tarosay/Wakayama-mruby-board/Schematic/README.md

DesignSpark PCBのデータです。
パーツライブラリは、下記にて公開しています。
https://bitbucket.org/tarosay/designspark_originallibrary
