tarosay/Wakayama-mruby-board/ruby関西勉強会.pdf

# Wakayama.rb

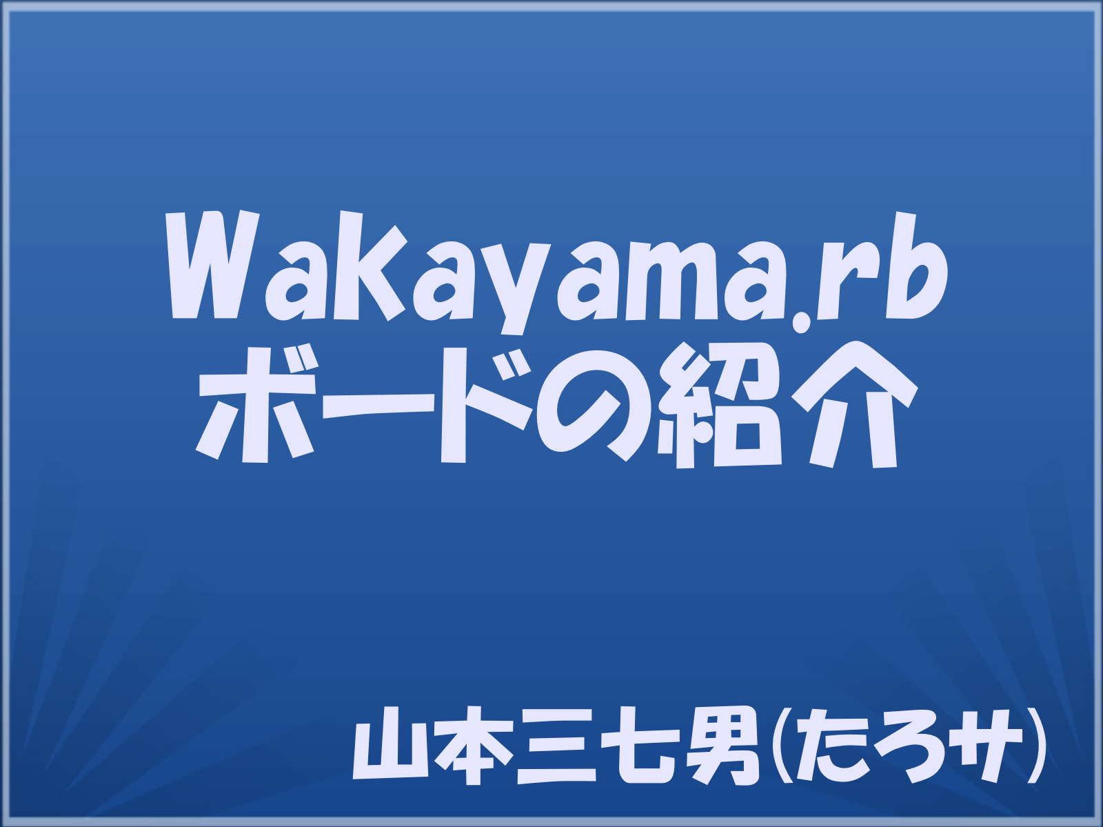
[picture p1: page 1]

# 山本三七男(たろサ)

# ボードの紹介

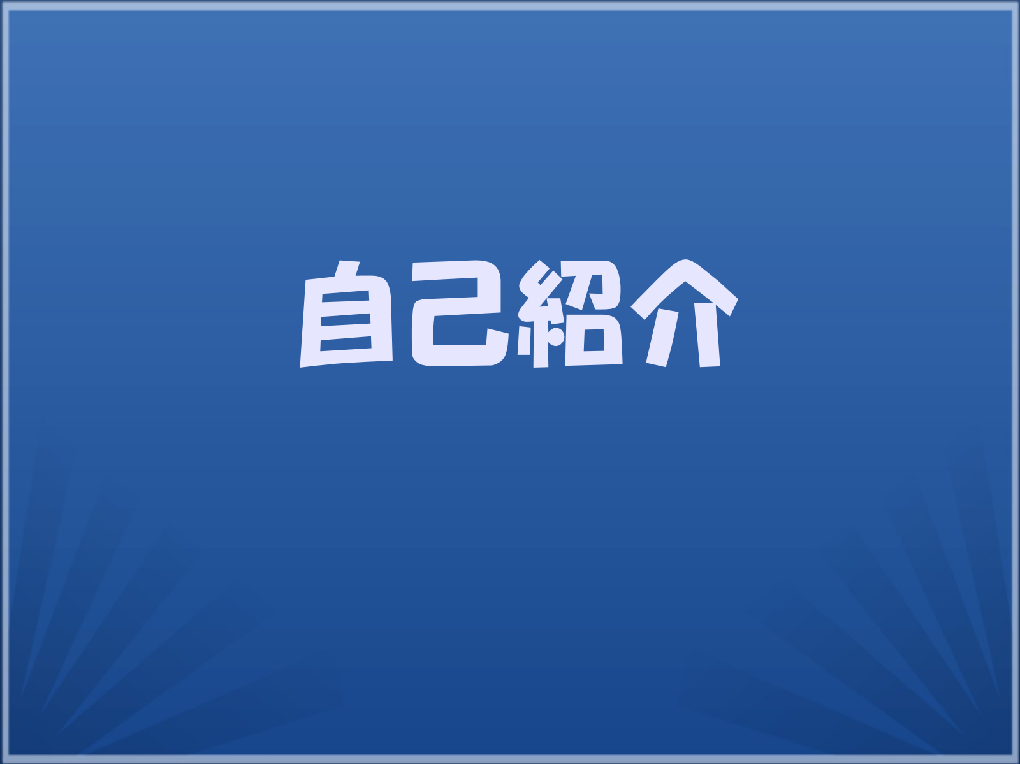
[picture p2: page 2]

# 自己紹介

## 自己紹介

## みかん

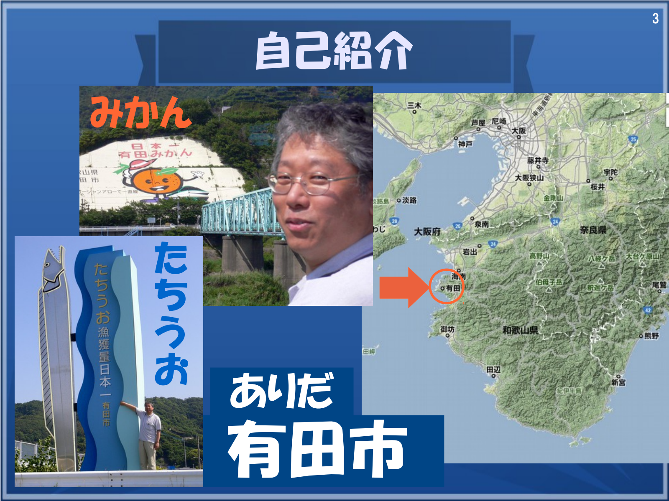
[picture p3: page 3]

3

# 有田市

## ありだ

### たちうお

## 自己紹介

## フリーランスのプログラマを やっています。 さらに、

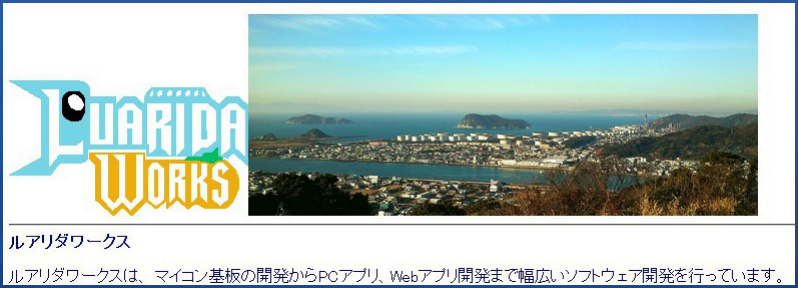
[picture p4: figure]

5

## 自己紹介

## 二足のわらじ

## ビジュアル・テクノロジー研究所

所属

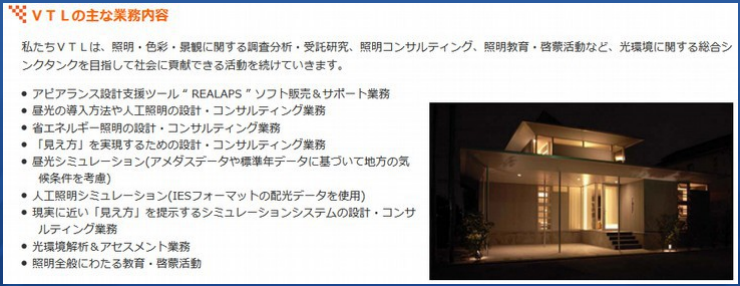
[picture p5: figure]

## ＶＴＬの保有技術

## 自己紹介

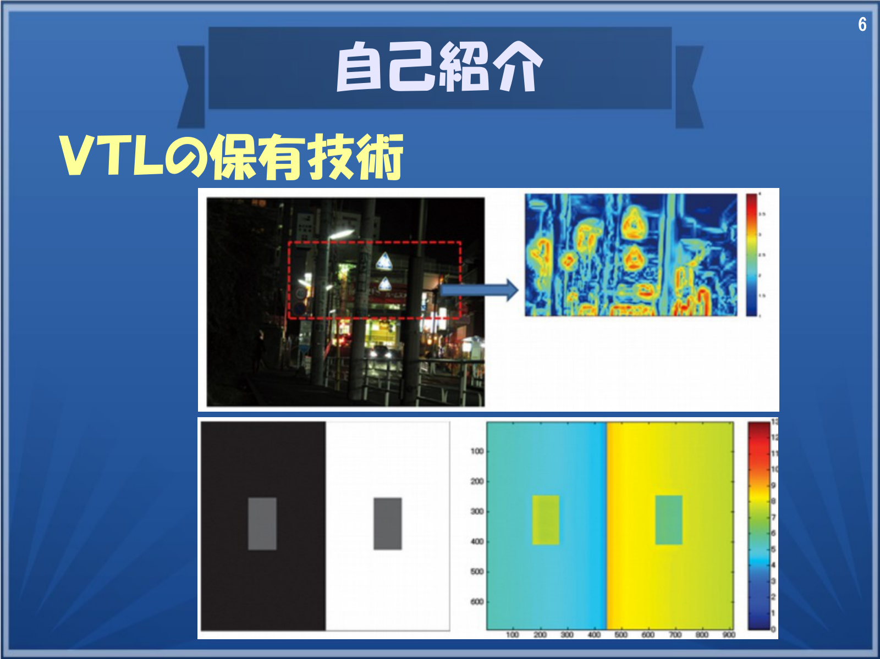
[picture p6: page 6]

6

## 自己紹介

### 毎月、和歌山でRuby勉強会を 行っています。

## Wakayama.rb主催

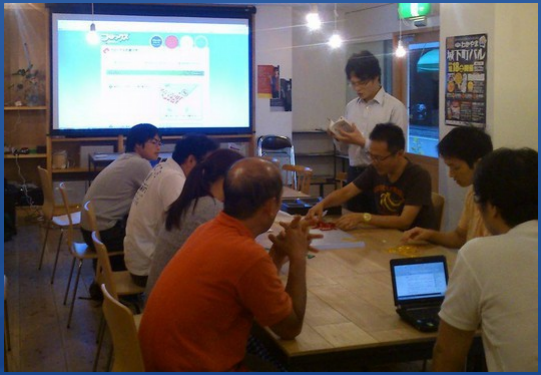
[picture p7: figure]

## 発足の秘密

# Wakayama.rb 発足の理由！！

# 帰りの紀州路快速で 何が話されたか? 発表の最後に！

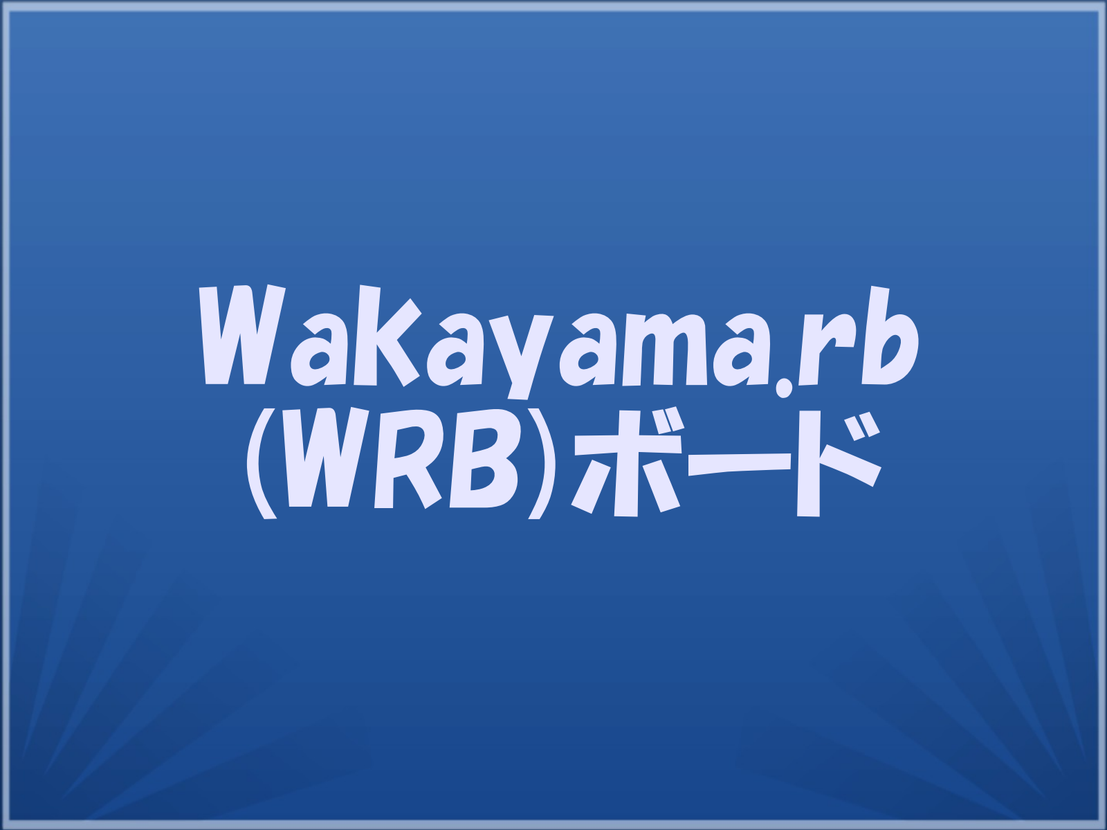
[picture p8: page 9]

# Wakayama.rb (WRB)ボード

10

## WRBボード

## mrubyボード設計・製作

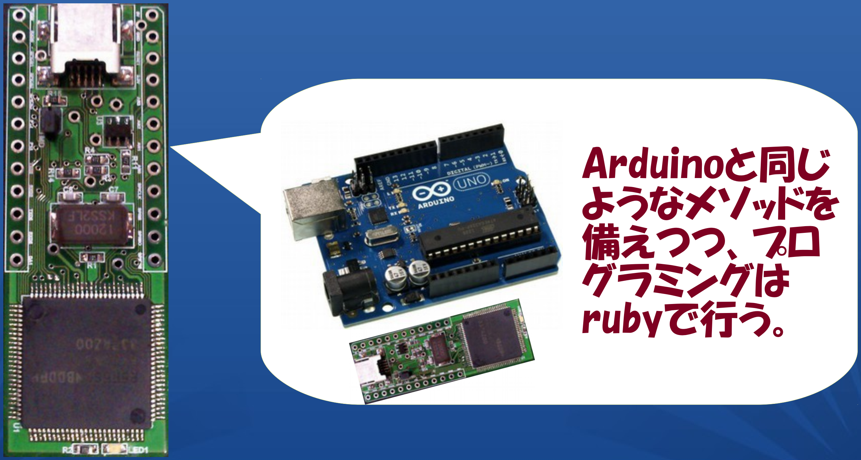
[picture p9: figure]
Arduinoと同じ ようなメソッドを 備えつつ、プロ グラミングは rubyで行う。

# ハードウェア

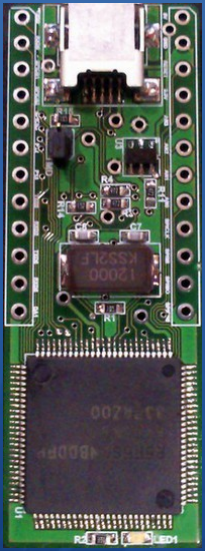
[picture p10: figure]

ボード機能
USBファンクション端子（mini-B）、
LED 1個、
I/Oピン 20ピン、
シリアル 3個、
SPI 1個、
A/D 4個、
I2C、PWM、サーボは自由割当て

## MCU RX63N FlashROM：1Mバイト RAM：128Kバイト データ用Flash：32Kバイト

## ピンアサイン

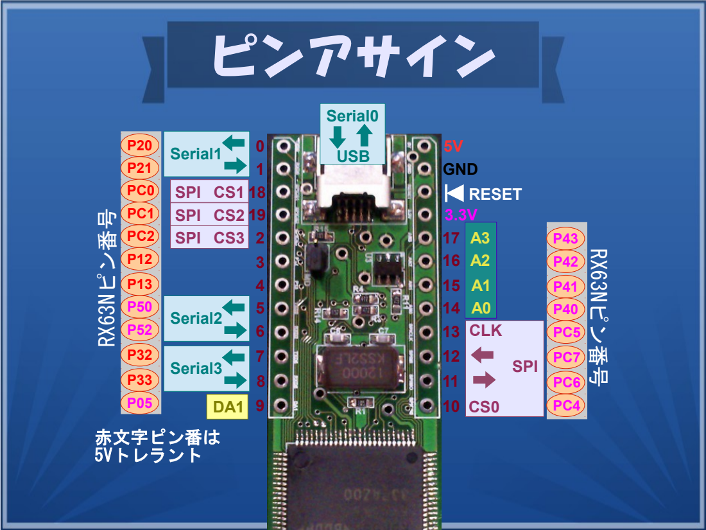
[picture p11: page 12]

## ピンアサイン

## Ver 2.0

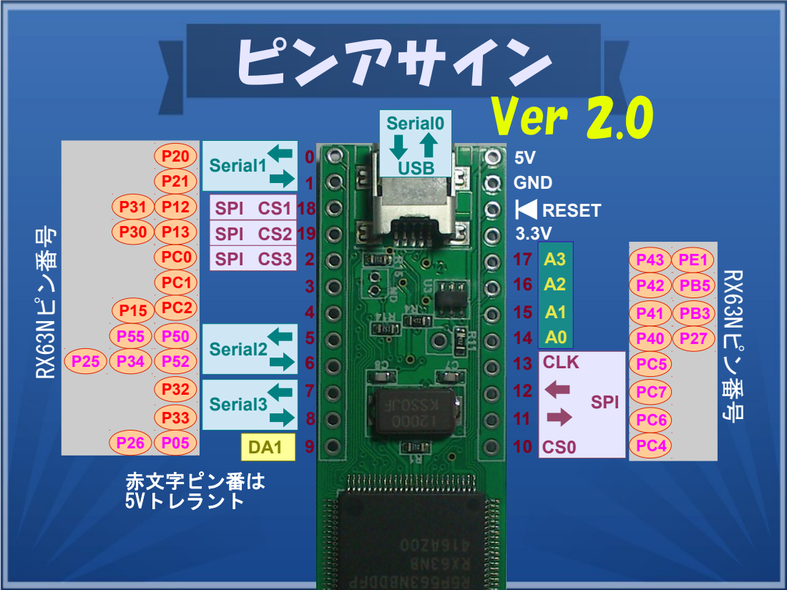
[picture p12: page 13]

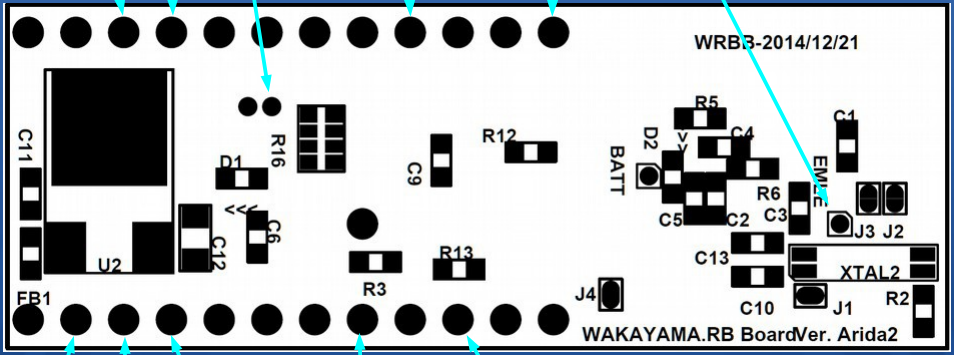
[picture p13: figure]

TCK

MD TRST

SPIMISO

TMS TDI | TDO

GND REST

EMLE

V3.3

## J T A G

## オープンソース化

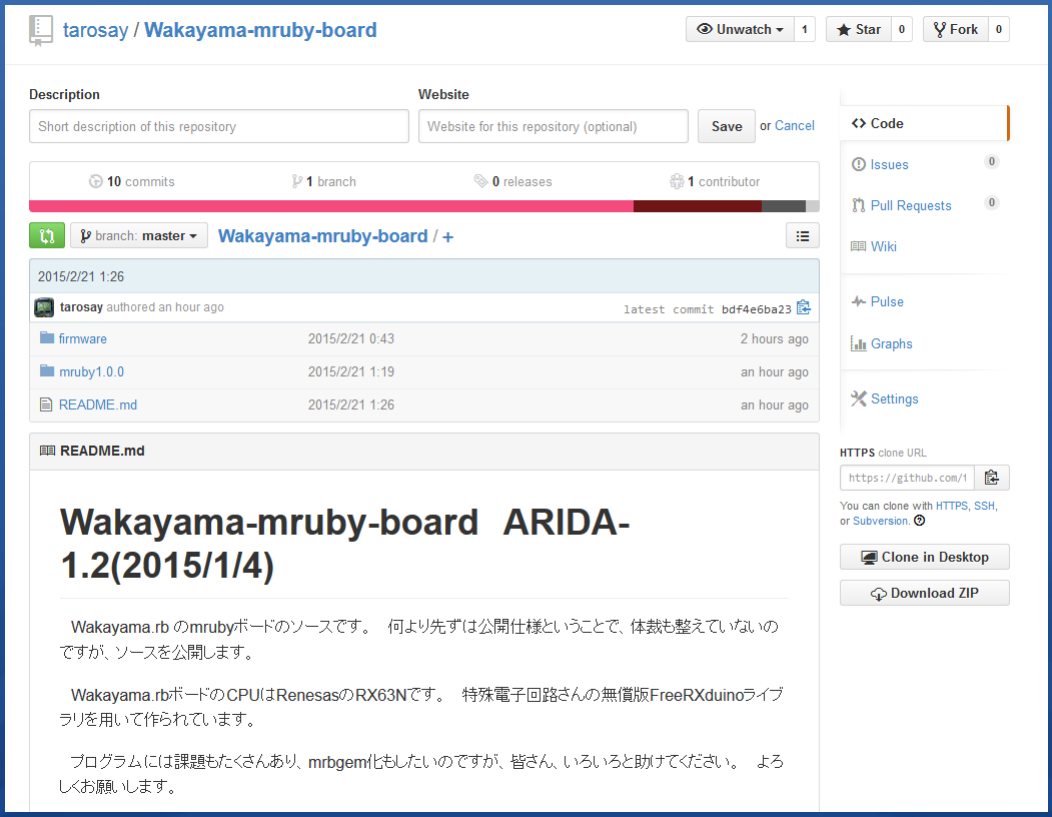
[picture p14: figure]

## ビルド環境

### Windows 編 Cygwinのインストール https://www.cygwin.com/

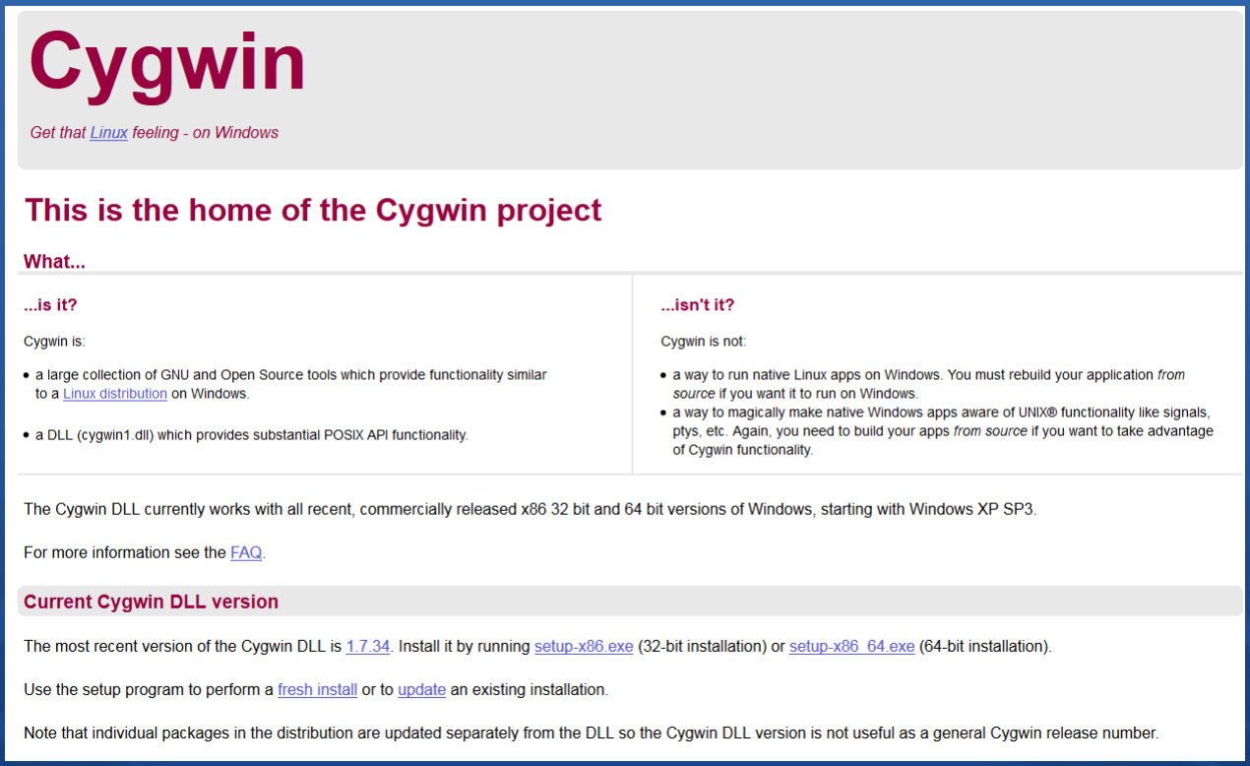
[picture p15: figure]

## ビルド環境

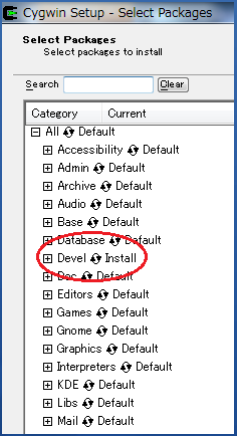
[picture p16: figure]

### Cygwinのインストール

### Develをインストールすれば OKでしょう。

## RX-ELF-GCC環境

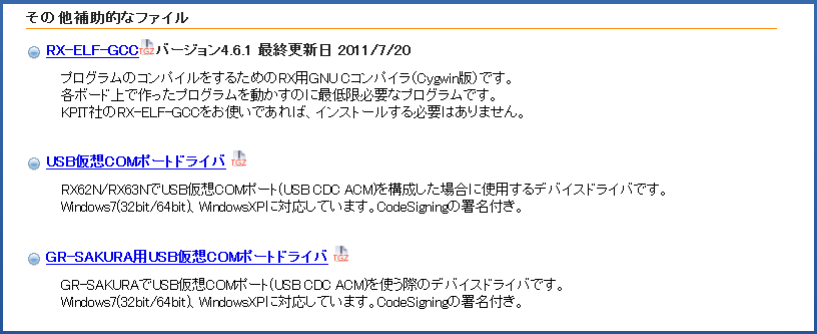
[picture p17: figure]

### 特殊電子回路(株)さんのFreeRXduinoサイト から、RX-ELF-GCCをダウンロード

http://rx.tokudenkairo.co.jp/freesoft.html

## RX-ELF-GCC環境

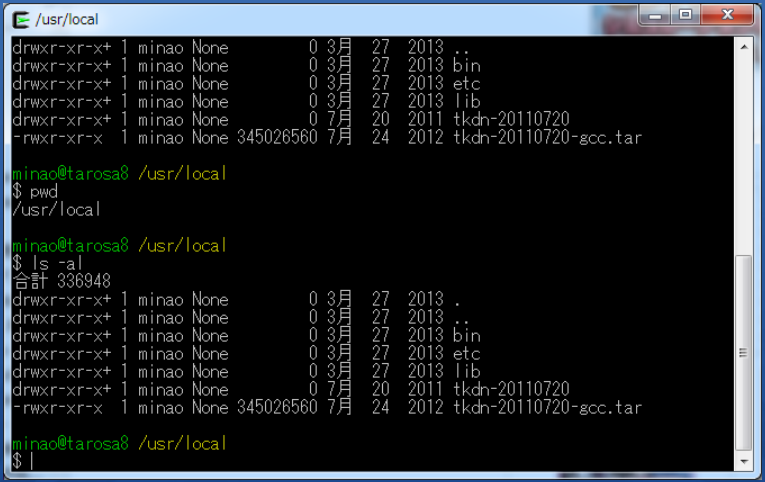
[picture p18: figure]

tar jxvf tkdn-20110720-gcc.tar.bz2

## RX-ELF-GCC環境

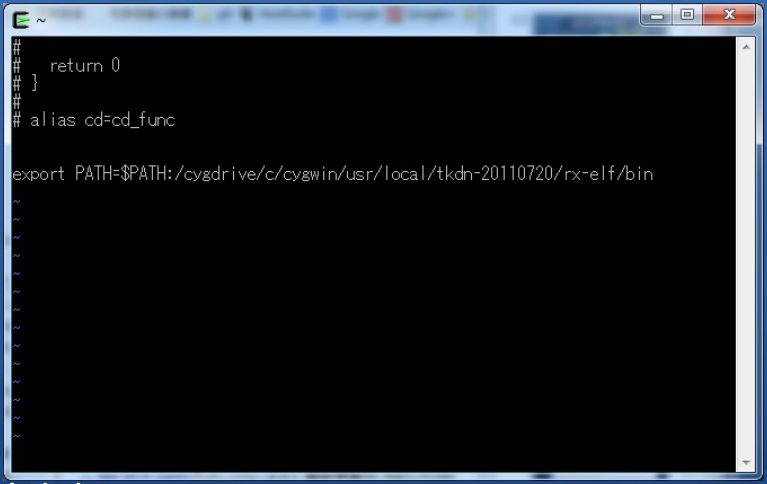
[picture p19: figure]

$ vim .bashrc

export PATH=$PATH:/cygdrive/c/cygwin/usr/local/tkdn-20110720/rx-elf/bin

## RX-ELF-GCC環境

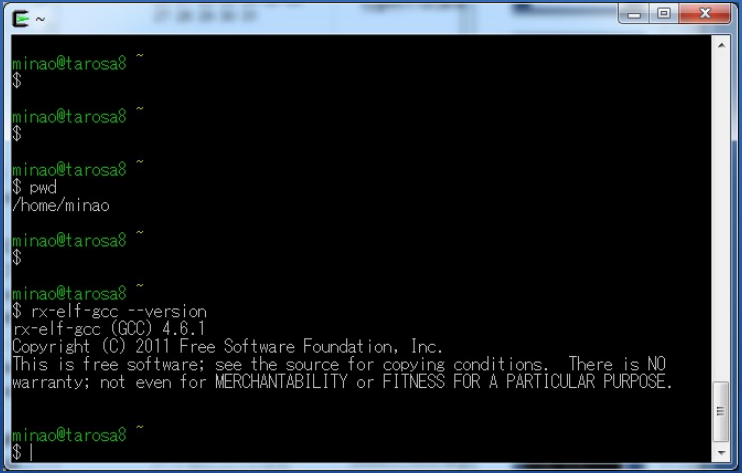
[picture p20: figure]

$ rx-elf-gcc --version

## mrubyのmake

### ただし、mruby1.0.0

## ただし、mruby1.0.0

# ただし、mruby1.0.0

ただし、mruby1.0.0

## mrbconf.h

ただし、mruby1.0.0

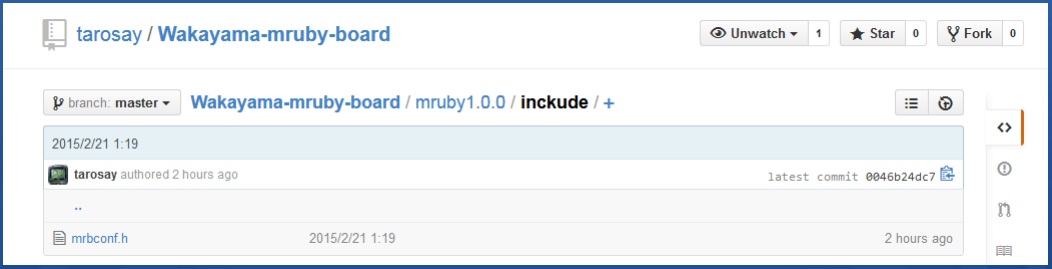
[picture p21: figure]

include/mrbconf.hを入れ替える

git clone https://github.com/tarosay/Wakayama-mruby-board.git

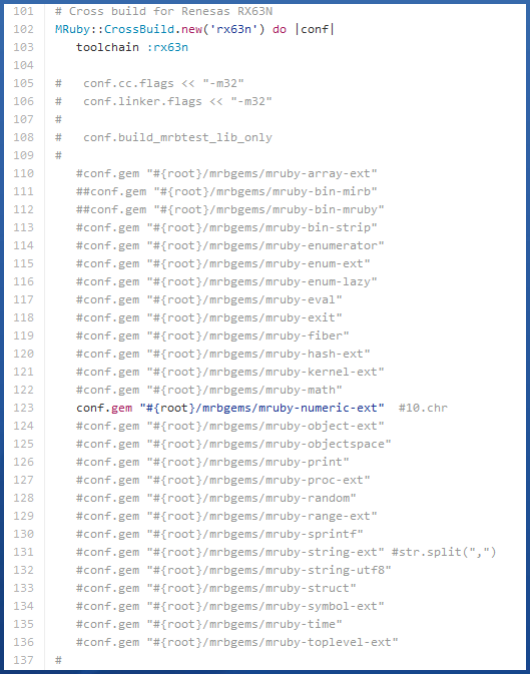
[picture p22: figure]

build_config.rbにRX63N
が追加されている。

## build_config.rb

## rx63n.rake

toolchains/にrx63n.rakeの追加

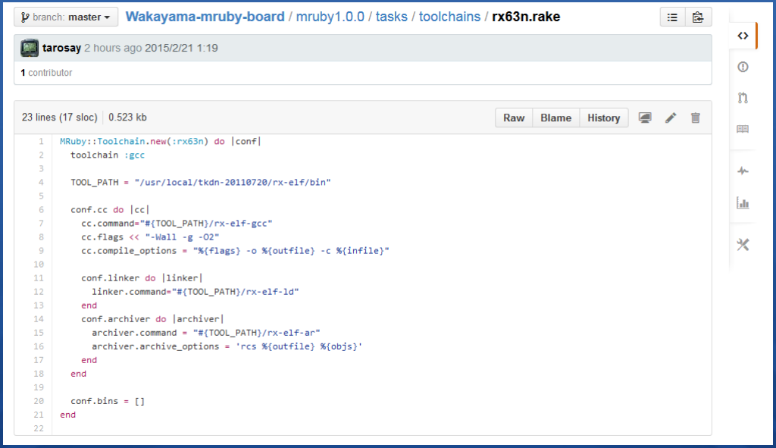
[picture p23: figure]

## mruby make

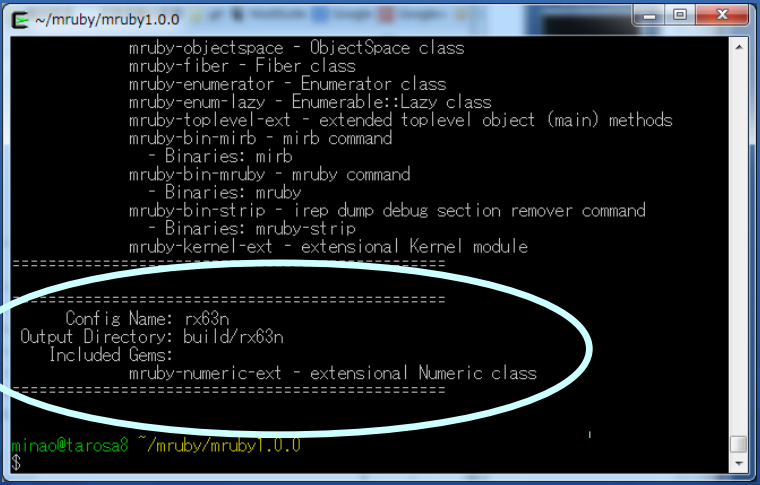
[picture p24: figure]

$ make

## libmruby.a

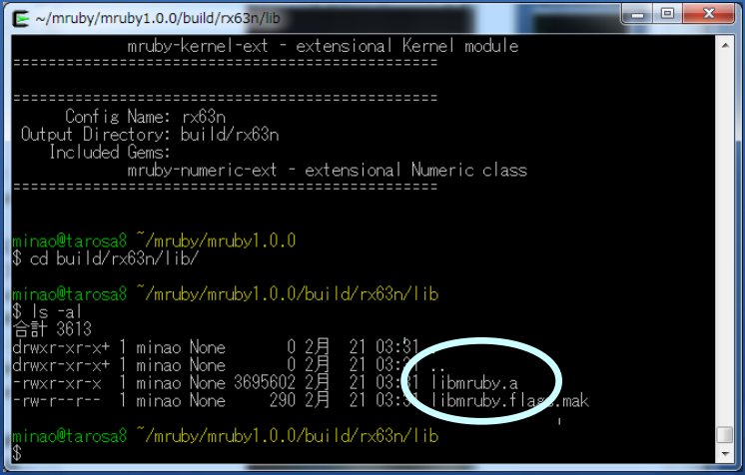
[picture p25: figure]

build/rx63n/lib/libmruby.a

Wakayama-mruby-board

Wakayama-mruby-boardをmakeする

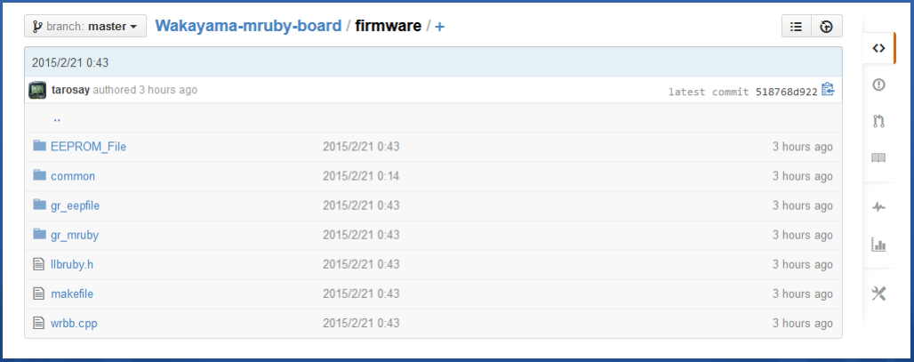
[picture p26: figure]

Wakayama-mruby-board

Wakayama-mruby-boardをmakeする

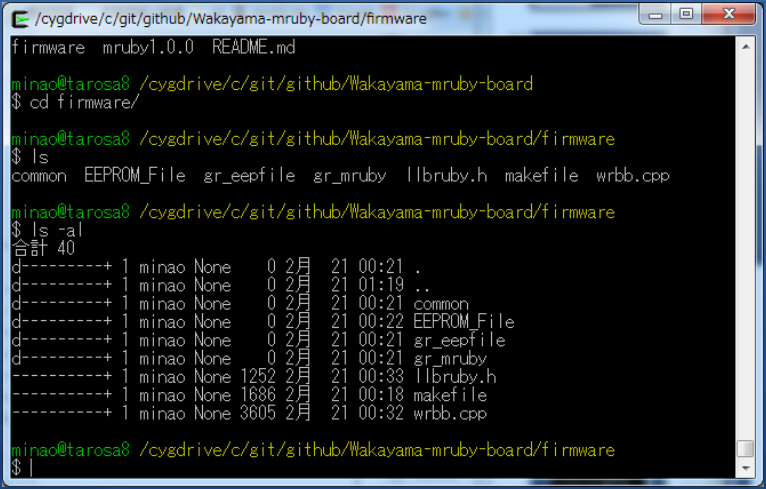
[picture p27: figure]

Wakayama-mruby-board

gr_mruby/以下にlibmruby.aをコピーする

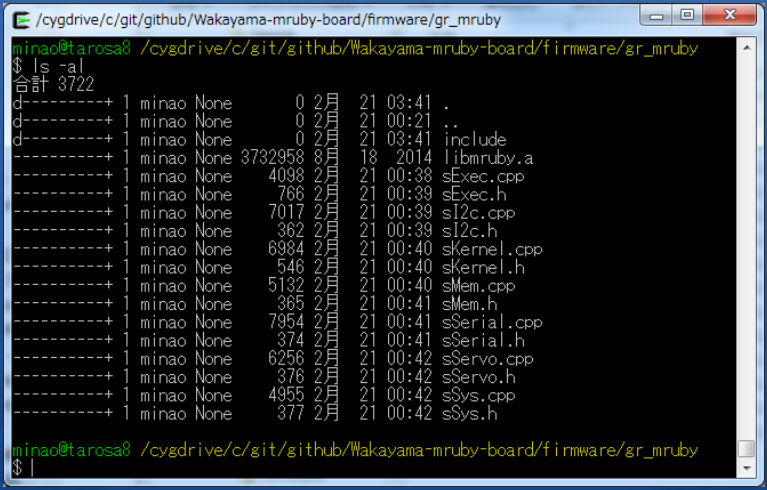
[picture p28: figure]

Wakayama-mruby-board

gr_mruby/include/にmruby.hをコピーする gr_mruby/include/にmruby/をコピーする

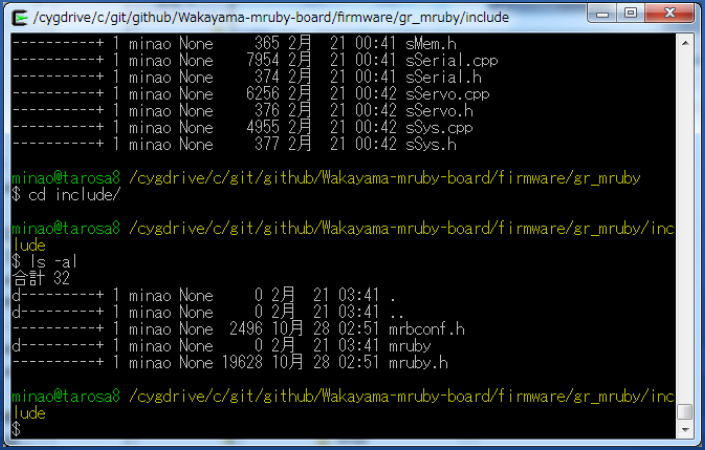
[picture p29: figure]

無償版FreeRXduinoの
ダウンロード

FreeRXduino V1.20 GCC,CubeSuite+,HEW対応版 をダウンロードします

http://rx.tokudenkairo.co.jp/freesoft.html

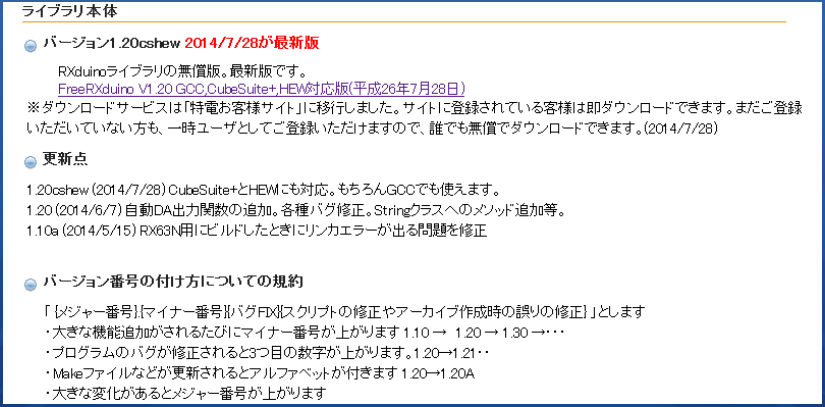
[picture p30: figure]

ライブラリからコピー

FreeRXduinoライブラリ V1.20 から、common/と include/とlib/をコピーします。

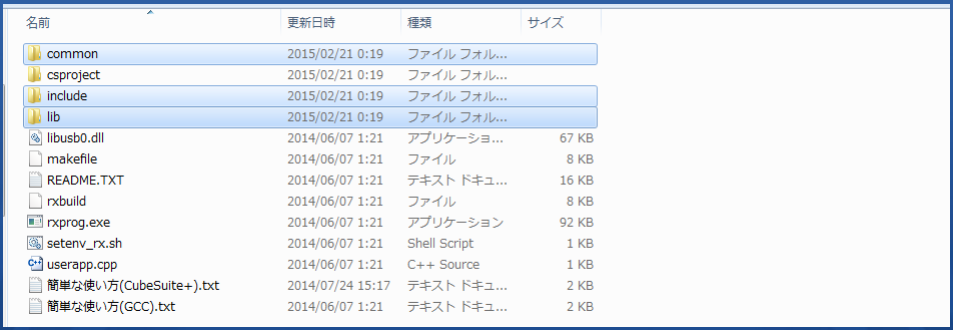
[picture p31: figure]

## make

あとは、makeするだけ

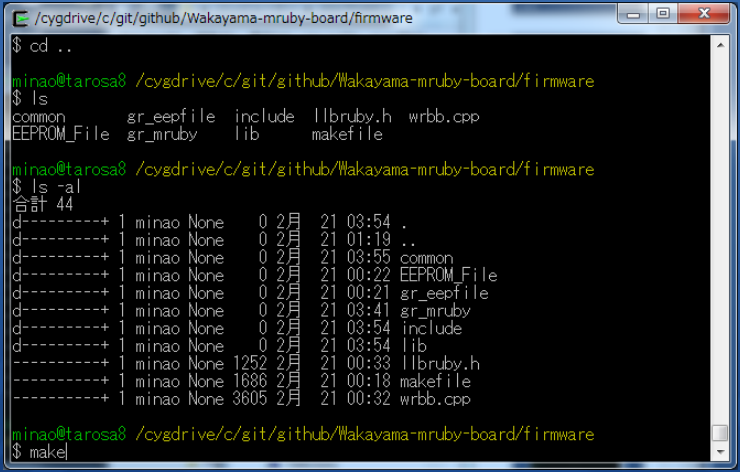
[picture p32: figure]

## wrbb.mot生成

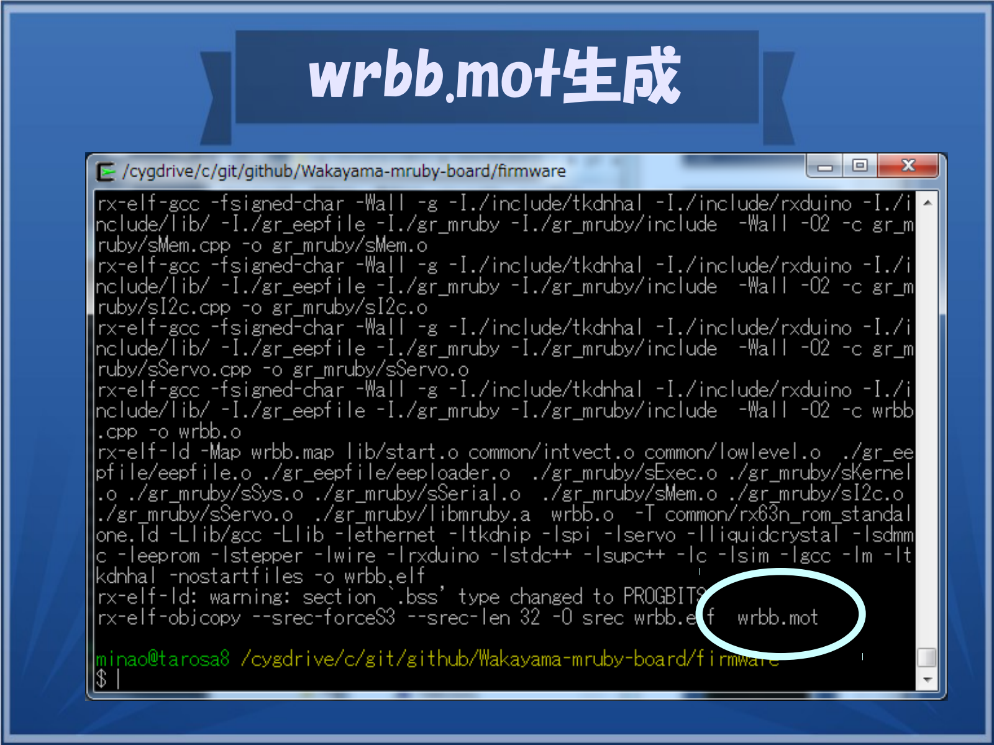
[picture p33: page 35]

## WRBボード書き込み

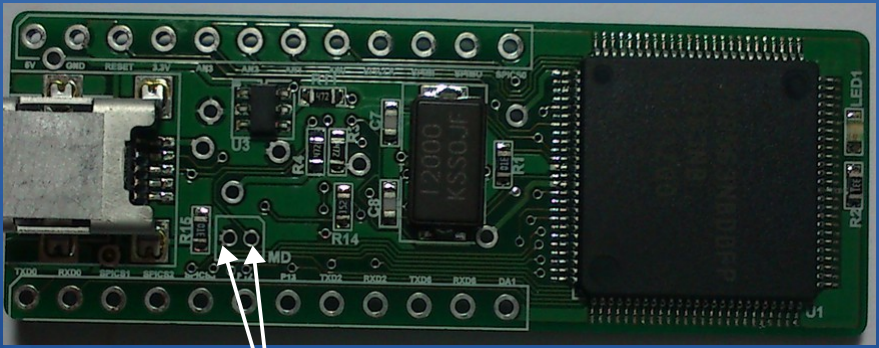
[picture p34: figure]

ここをショートします。

## WRBボード書き込み

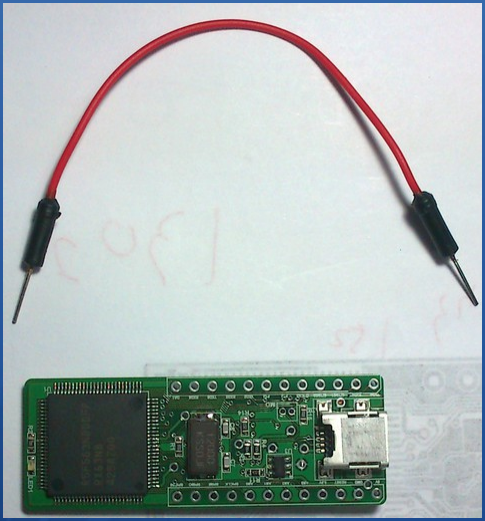
[picture p35: figure]

## みんな持ってる ブレッドボード用配線

## WRBボード書き込み

ここをショートします。

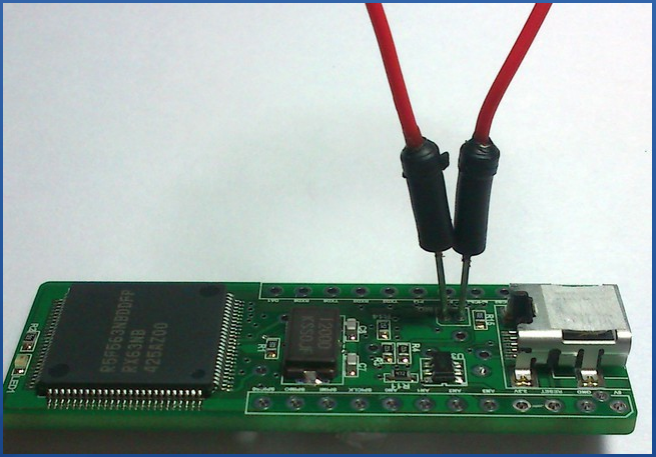
[picture p36: figure]

## WRBボード書き込み

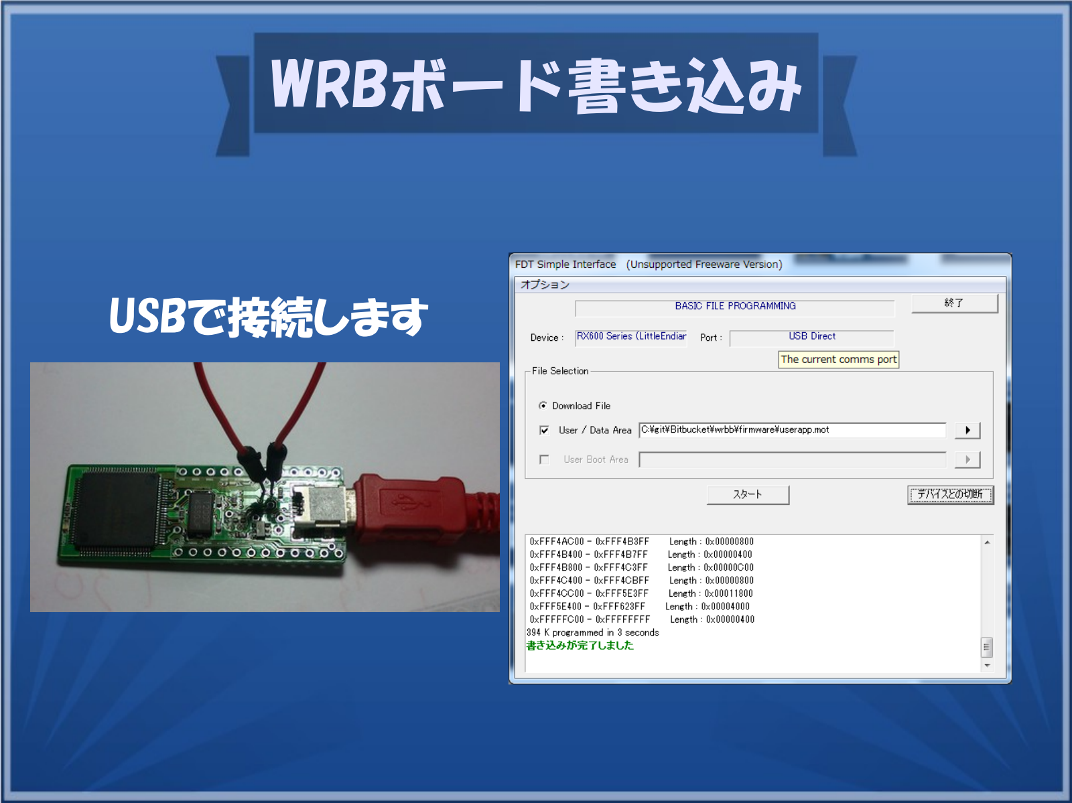
[picture p37: page 39]

USBで接続します

## 時間切れです

### すいません、後は購入してくれた方に・・・。

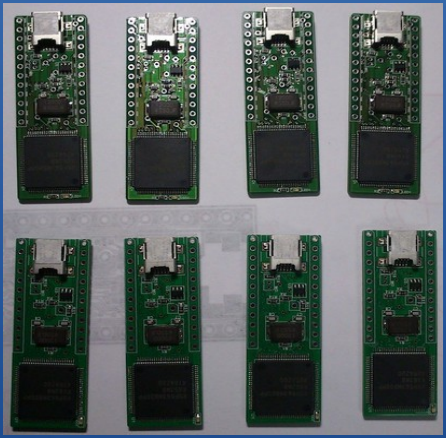
[picture p38: figure]

### 3/22(日) NT京都出展します。

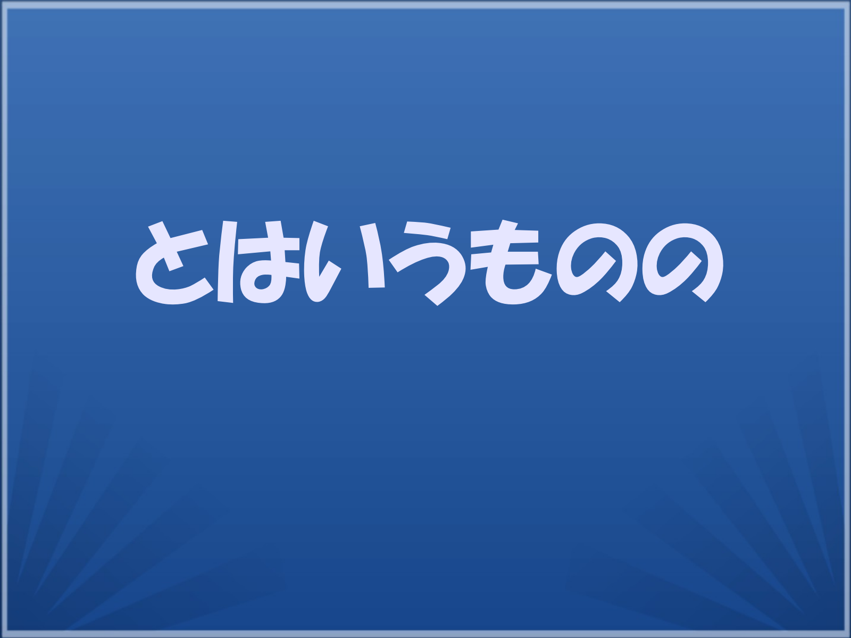
[picture p39: page 41]

# とはいうものの

## 時間切れです

### 売れるものは、4枚しか出来ていません。

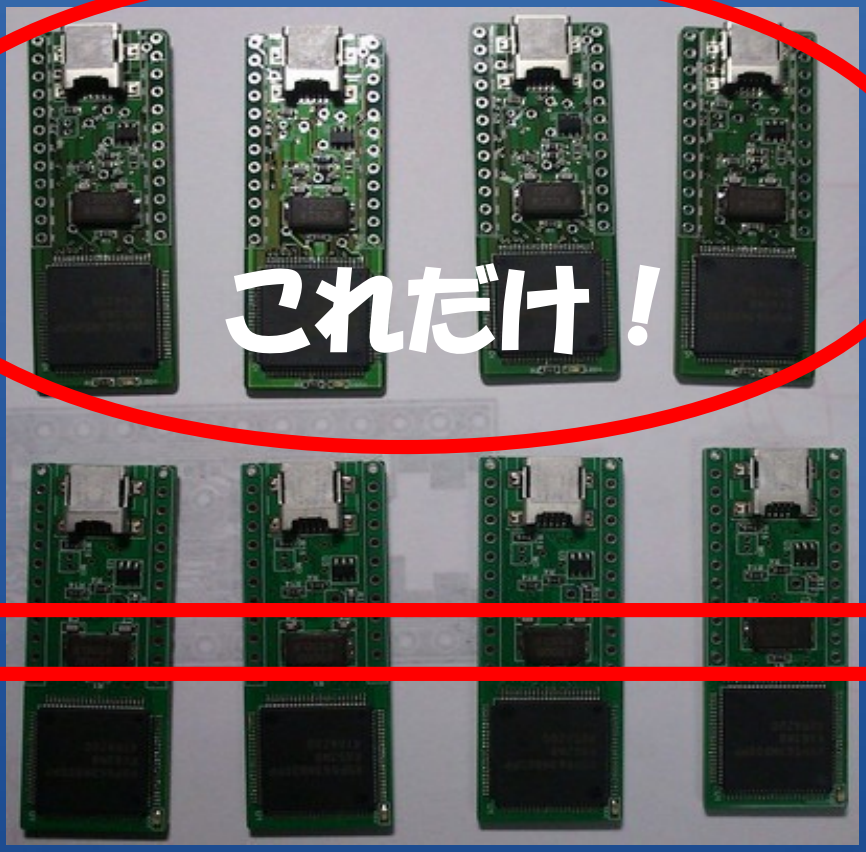
[picture p40: figure]
これだけ！

### 3/22(日) NT京都出展します。

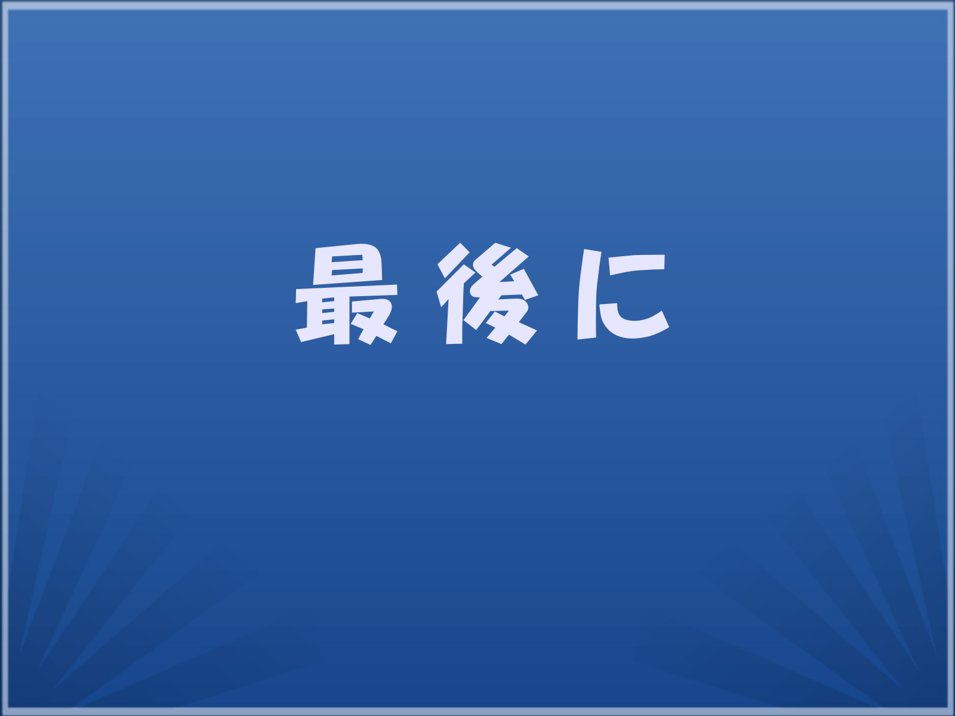
[picture p41: page 43]

# 最 後 に

## mrubyでIoTが変る

### mrubyボード

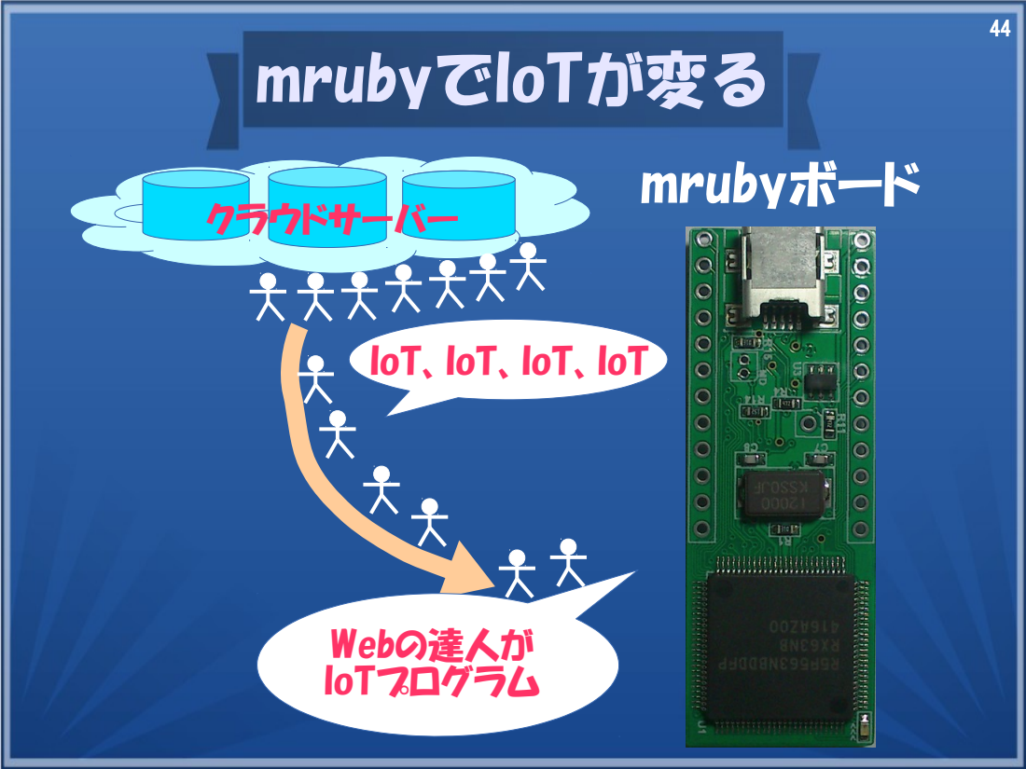
[picture p42: page 44]
小 桜 クラウドサーバー; Webの達人が IoTプログラム

IoT、IoT、IoT、IoT

## mrubyでIoTが変る

## サーバ～組み込み

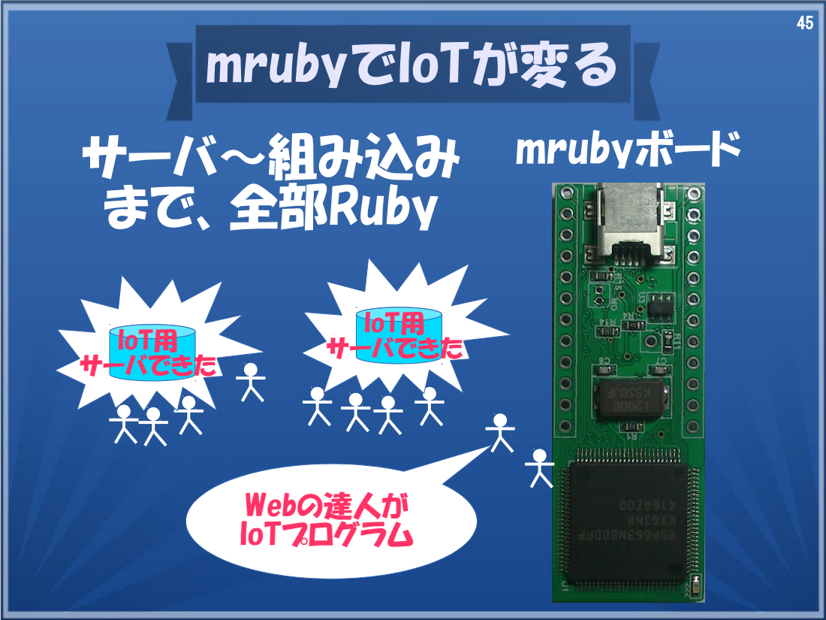
[picture p43: page 45]
Webの達人が IoTプログラム; IoT用 IoT用; サーバできた サーバできた; まで、全部Ruby; mrubyボード

# Wakayama.rb

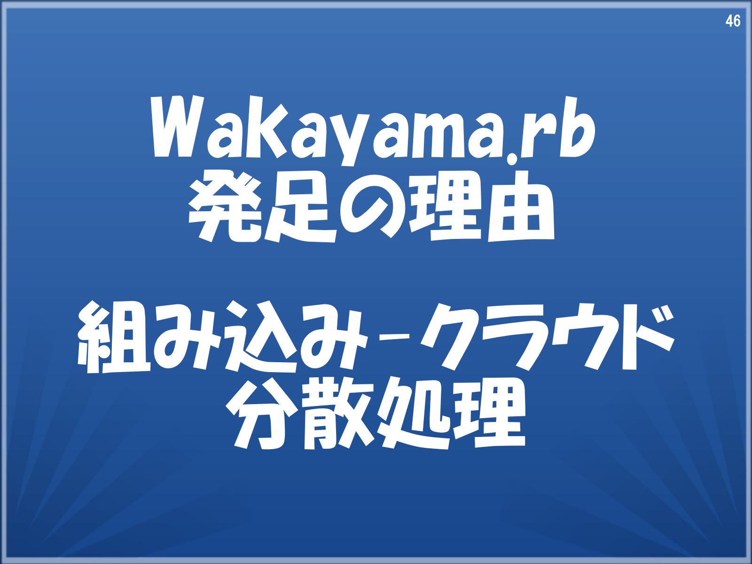
[picture p44: page 46]

46

# 組み込み-クラウド 分散処理

46

# 発足の理由

### クラウド分散

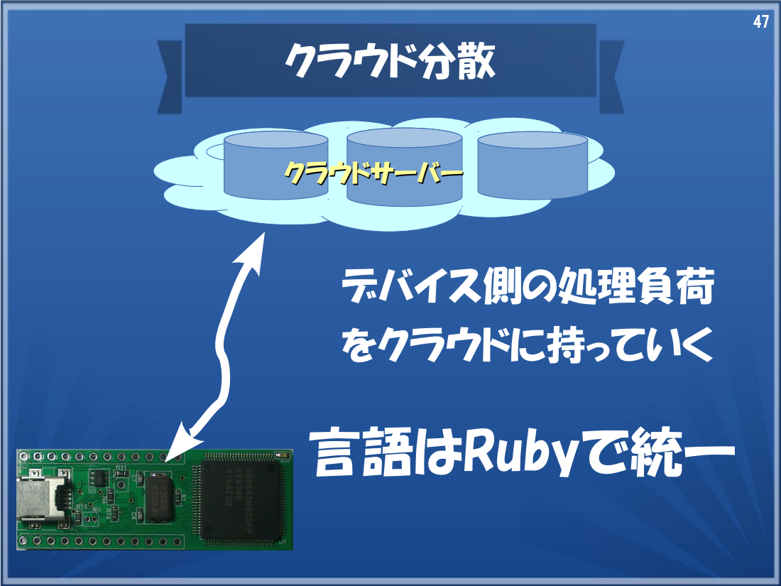
[picture p45: page 47]
デバイス側の処理負荷; をクラウドに持っていく; クラウドサーバー; 言語はRubyで統一

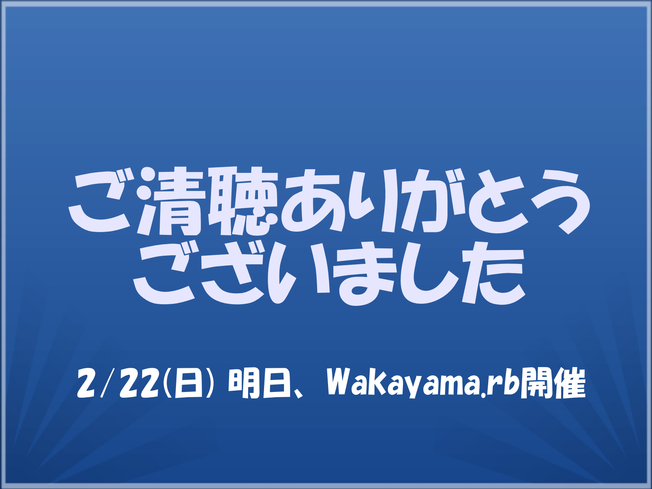
[picture p46: page 48]

# ご清聴ありがとう ございました

### 2/22(日) 明日、 Wakayama.rb開催
