tarosay/Wakayama-mruby-board/BoardDescription/WRB board hands-on text.pdf

# Rubyボードハンズオン テキスト

## Wakayama.rb 山本三七男(たろサ)

2015/12/12

## 2015/12/13修正版

目次

ハード仕様・・・・・・・・・・・・・・・・・・ 3
ピンマップ・・・・・・・・・・・・・・・・・・ 4
基本ソフト仕様・・・・・・・・・・・・・・・・ 5
ハンズオンで使用するRubyの構文・・・・・・・・ 7 仮想COMポートドライバインストール ・・・・・・ 9 Rubyボードの接続・・・・・・・・・・・・・・・ 11 Rubicの使い方 ・・・・・・・・・・・・・・・・ 13

ハンズオン
1.LEDチカチカ ・・・・・・・・・・・・・・・・ 29 2.Hello World!とLEDチカチカ ・・・・・・・・・ 30 3.スイッチ・・・・・・・・・・・・・・・・・・ 31 4.ブザー・・・・・・・・・・・・・・・・・・・ 33 5.ブザーとスイッチ・・・・・・・・・・・・・・ 35 6.光センサとAD変換・・・・・・・・・・・・・・ 37 7.光センサとAD変換2 ・・・・・・・・・・・・・ 39 8.光センサとブザー・・・・・・・・・・・・・・ 41

プログラムの入手方法・・・・・・・・・・・・・ 43

## ハード仕様

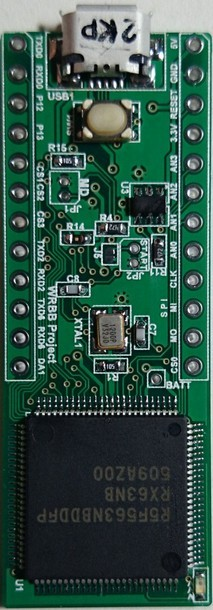
[picture p49: figure]

## MCU 32ビットCPU RX63N(100ピン) 96MHz FlashROM：1Mバイト RAM：128Kバイト データ用Flash：32Kバイト ボード機能 USBファンクション端子（micro-B） LED 1個 I/Oピン 20ピン シリアル 3個(+1個可能) SPI 1個 A/D 4個 RTC I2C、PWM、Servoは自由割当てです。 リセットボタン

電　源

## 5V（USBバスパワード） サイズ

50×18mm

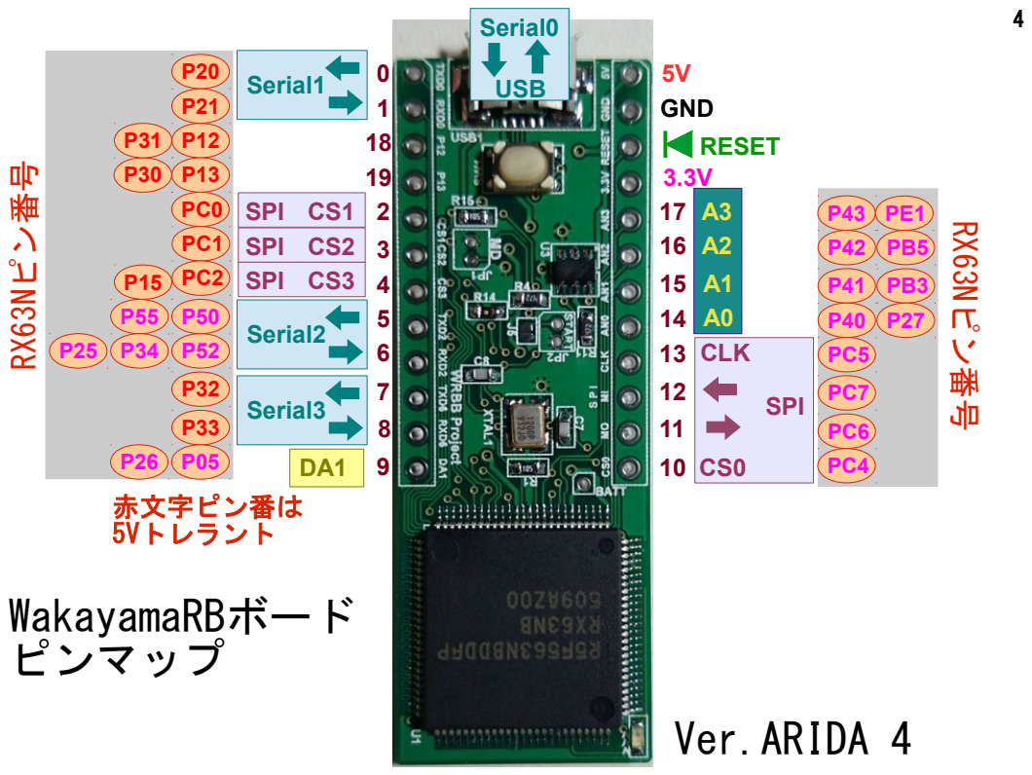
[picture p50: page 4]

カーネルクラス
pinMode(pin,mode)
digitalRead(pin)
digitalWrite(pin,value)
analogRead(number)
pwm(pin,value)
pwmHz(value)
analogDac(value)
delay(value)
millis()
micros()
led(sw)

システムクラス
System.exit()
System.setrun(filename)
System.version(r)
System.push(address,buf,length) System.pop(address,length) System.fileload()
System.reset()

ファイルクラス
MemFile.open(number,filename[,mode]) MemFile.close(number)
MemFile.read(number)
MemFile.write(number,buf,len) MemFile.seek(number,byte)
MemFile.copy(src,dst[,mode])

シリアルクラス
Serial.begin(number,bps)
Serial.setDefault(number)
Serial.print(number,string) Serial.println(number,string) Serial.read(number)
Serial.write(number,buf,len) Serial.available(number)
Serial.end(number)

I2Cクラス
I2c.sdascl(sda,scl)
I2c.write(id,address,data) I2c.read(id,addressL[,addressH]) I2c.begin(id)
I2c.lwrite(data)
I2c.end()
I2c.request(id,count)
I2c.lread()
I2c.freq(Hz)

サーボクラス
Servo.attach(ch,pin[,min,max]) Servo.write(ch,angle)
Servo.us(ch,us)
Servo.read(ch)
Servo.attached(ch)
Servo.detach(ch)

## 基本ソフト仕様

リアルタイムクロッククラス Rtc.begin() Rtc.setDateTime(Year,Month,Day,Hour,Minute,Second) Rtc.getDateTime()

## 基本ソフト仕様

# ハンズオンで使用する Rubyの構文

# 【繰り返しループ】 for i in 1..10 do Serial.print(0, i.to_s) #-> 1～10 end 10.times do|i| Serial.print(0, i.to_s) #-> 0～10 end while 条件文 [do]

処理

# end

## Rubyの構文 いろいろな書き方ができます

# 【条件演算子】C言語と同じです a == b bがaに等しい a != b bがaに等しくない a > b bよりaが大きい a >= b bよりaが大きいか等しい a < b bよりaが小さい a <= b bよりaが小さいか等しい

# 【条件分岐】 if 条件文 then

処理

# elsif 条件文 then

処理

# else

処理

# end 【if修飾子】 Serial.print(0, “Hello”) if a > 10 #->真のとき 【unless修飾子】 Serial.print(0, “Hello”) unless a > 10 #->偽のとき

# USB仮想COMポートドライバ インストール

## Windowsユーザのみ、 仮想COMポートドライバのインストールが必要です。

# Rubyボードは、特殊電子回路(株)さんの無償版FreeRXduinoライブラリを使用して製作さ れています。 特殊電子回路(株)さんのFreeRXduinoホームページから http://rx.tokudenkairo.co.jp/freesoft.html GR-SAKURA用USB仮想COMポートドライバをダウンロードしてインストールしてください。

# Rubyボードの接続

# 12 Rubyボードの接続

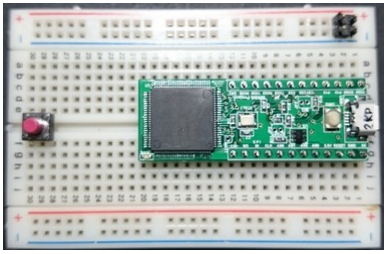
[picture p51: figure]

## ①WRBボードを差し込む

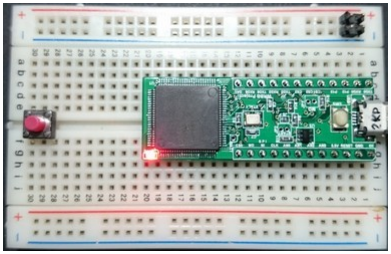
[picture p52: figure]

## ②USBを接続する。

# ここで、Windowsは仮想 COMポートドライバをインス トールします。

# Rubicの使い方

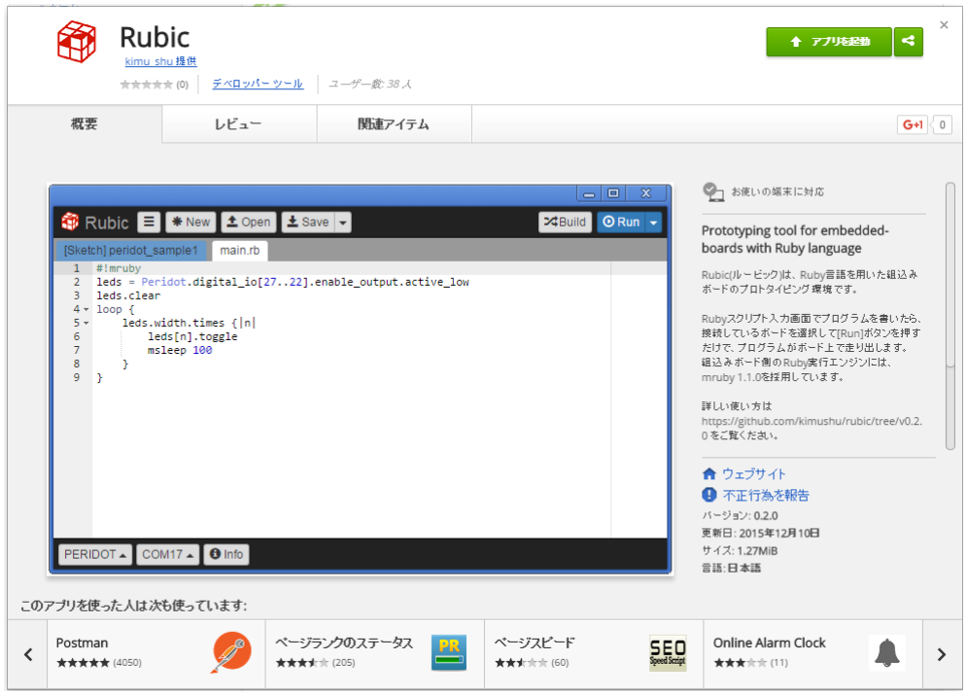
[picture p53: figure]

https://chrome.google.com/webstore/detail/rubic/mgbcgagfggopcpbbfgididddbnhhnhjp

## Rubicのインストール

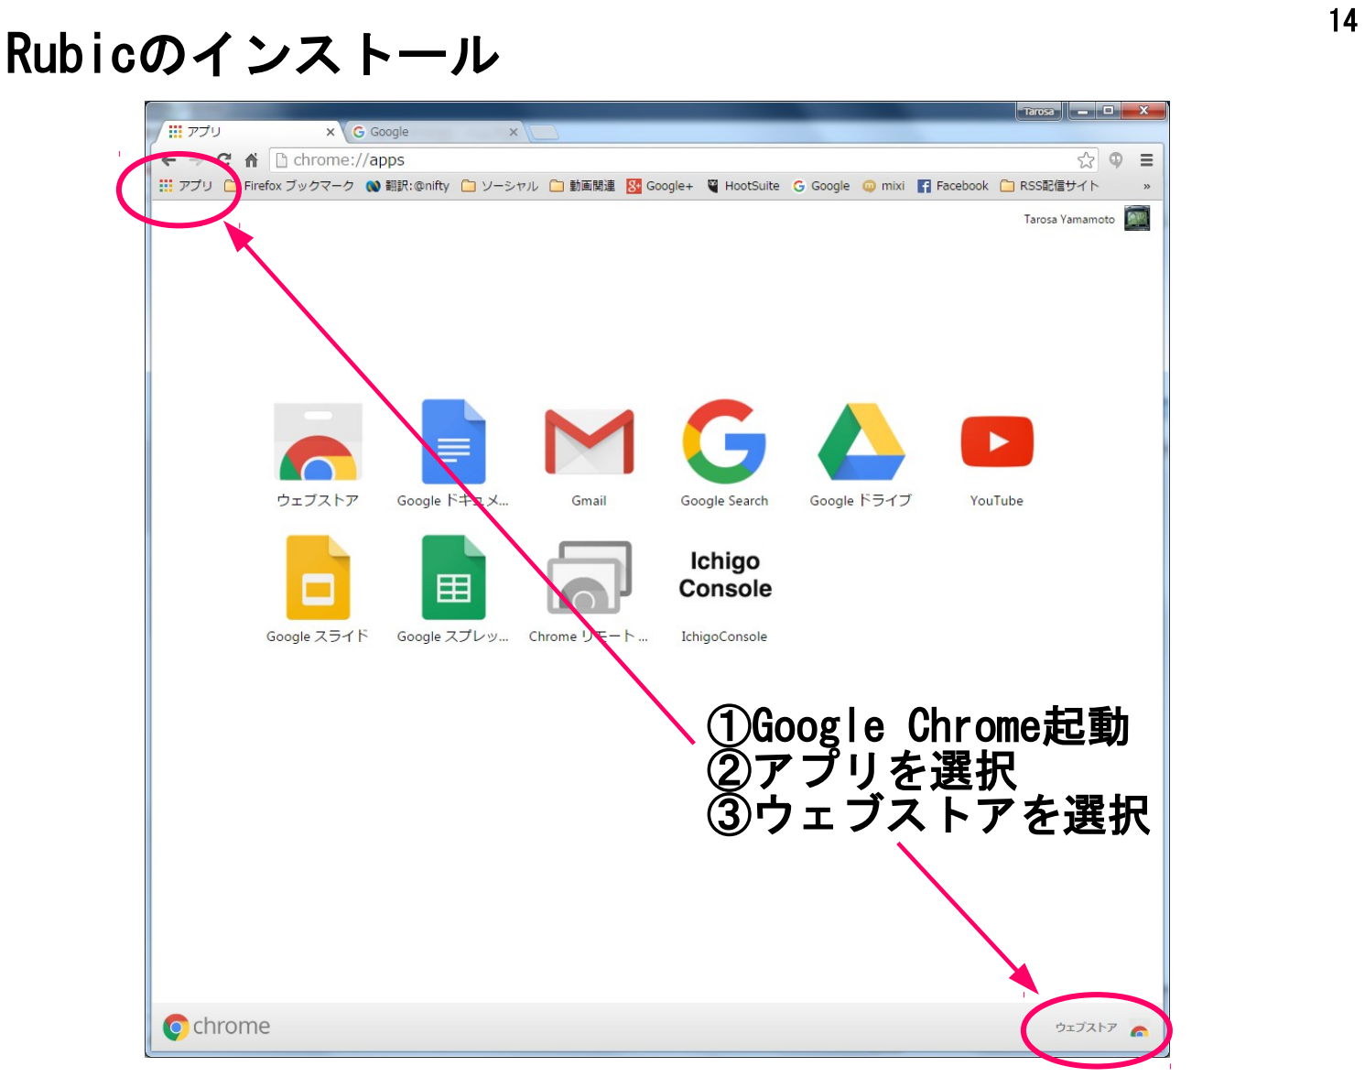
[picture p54: page 14]

## ①Google Chrome起動 ②アプリを選択 ③ウェブストアを選択

## Rubicのインストール

## ①Rubicと入れて検索する

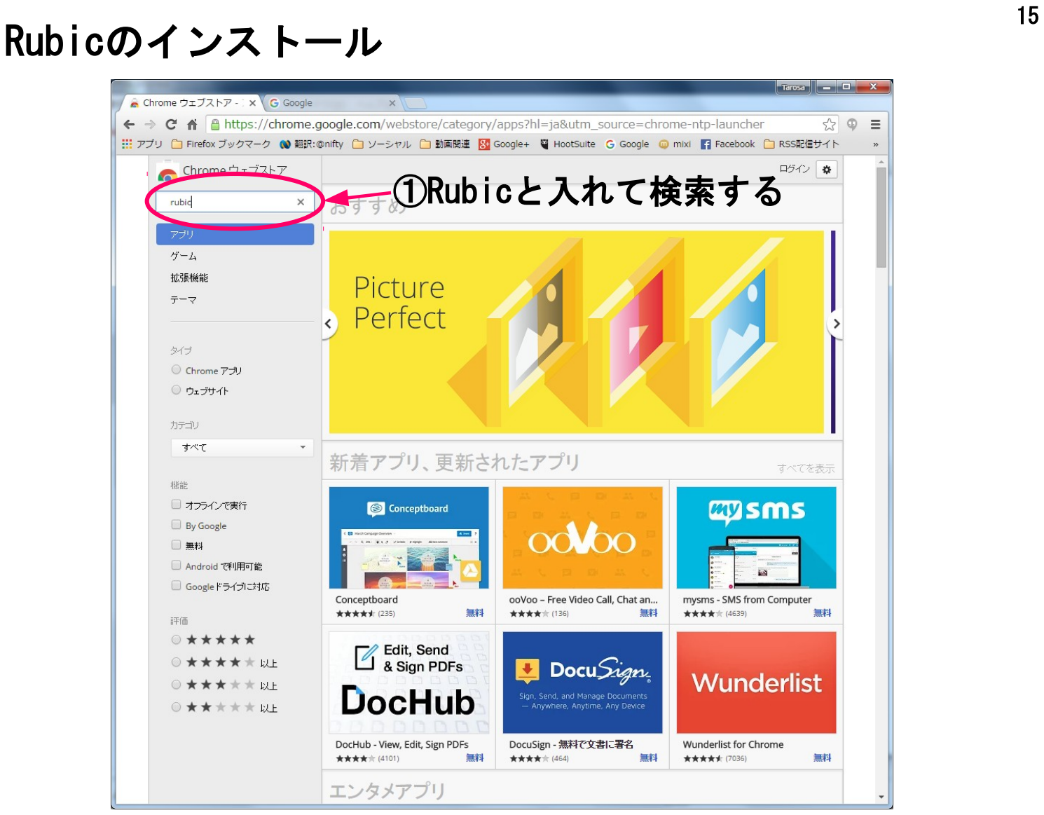
[picture p55: page 15]

## Rubicのインストール

## ①CHROMEに追加する

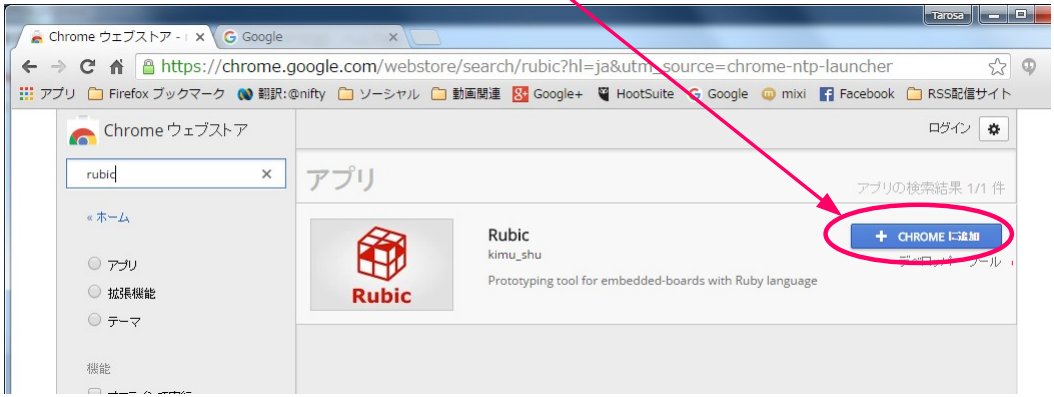
[picture p56: figure]

## Rubicのインストール ①アプリを追加を選ぶ

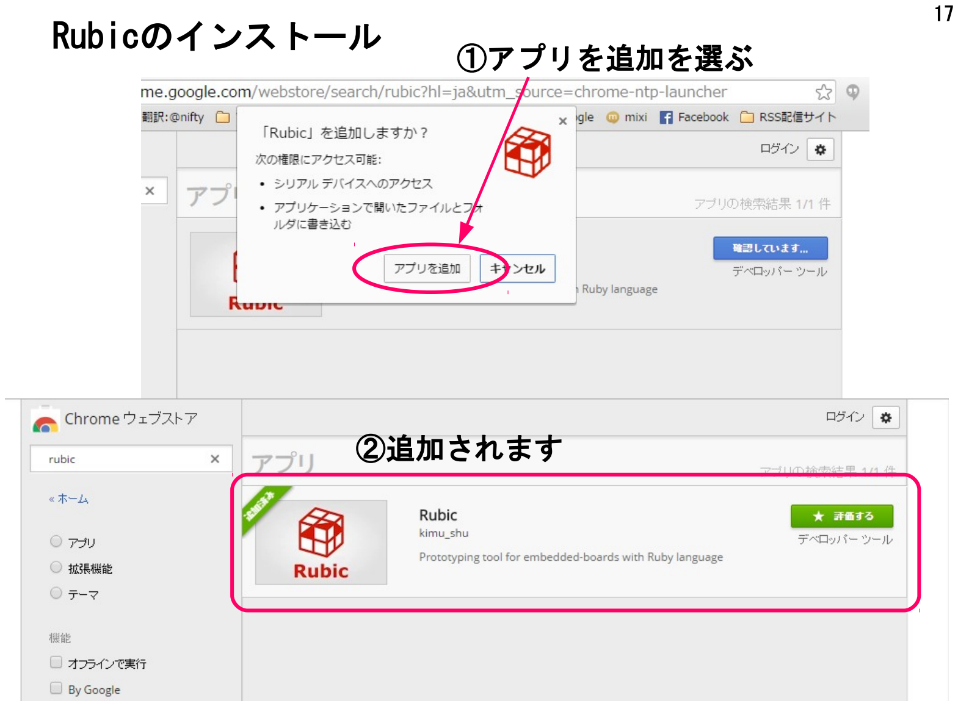
[picture p57: page 17]

## ②追加されます

## Rubicの起動

## ①Google Chrome起動 ②アプリを選択 ③Rubicを選択

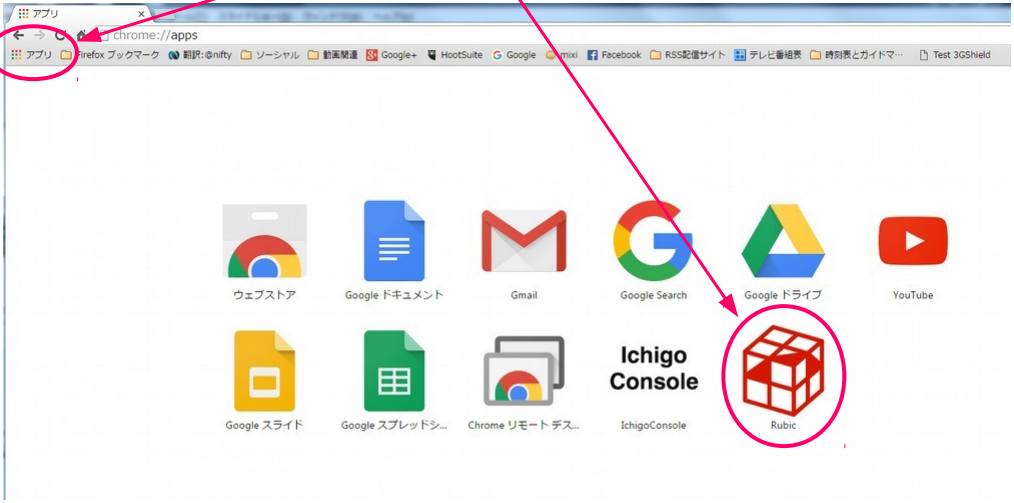
[picture p58: figure]

## Rubic: ボードとCOMポートの設定

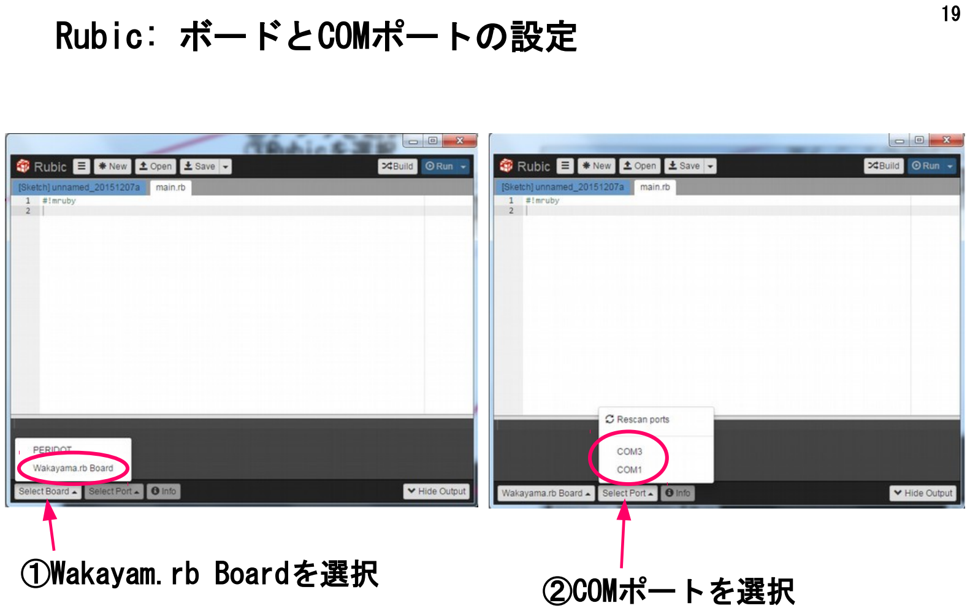
[picture p59: page 19]

①Wakayam.rb Boardを選択 | ②COMポートを選択

## Rubic: インフォーメーション表示

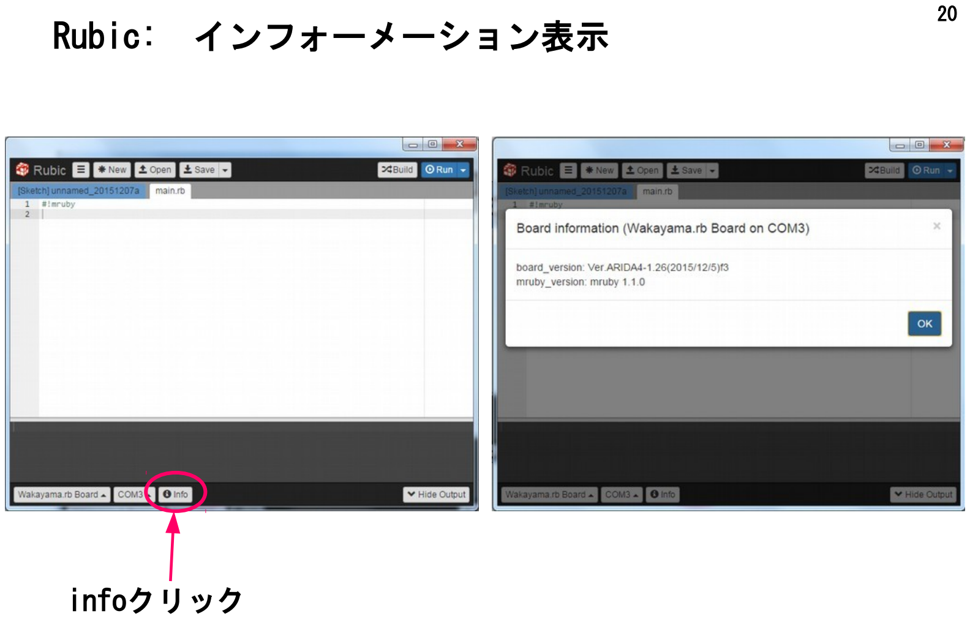
[picture p60: page 20]

## infoクリック

## Rubic: プログラム作成と実行

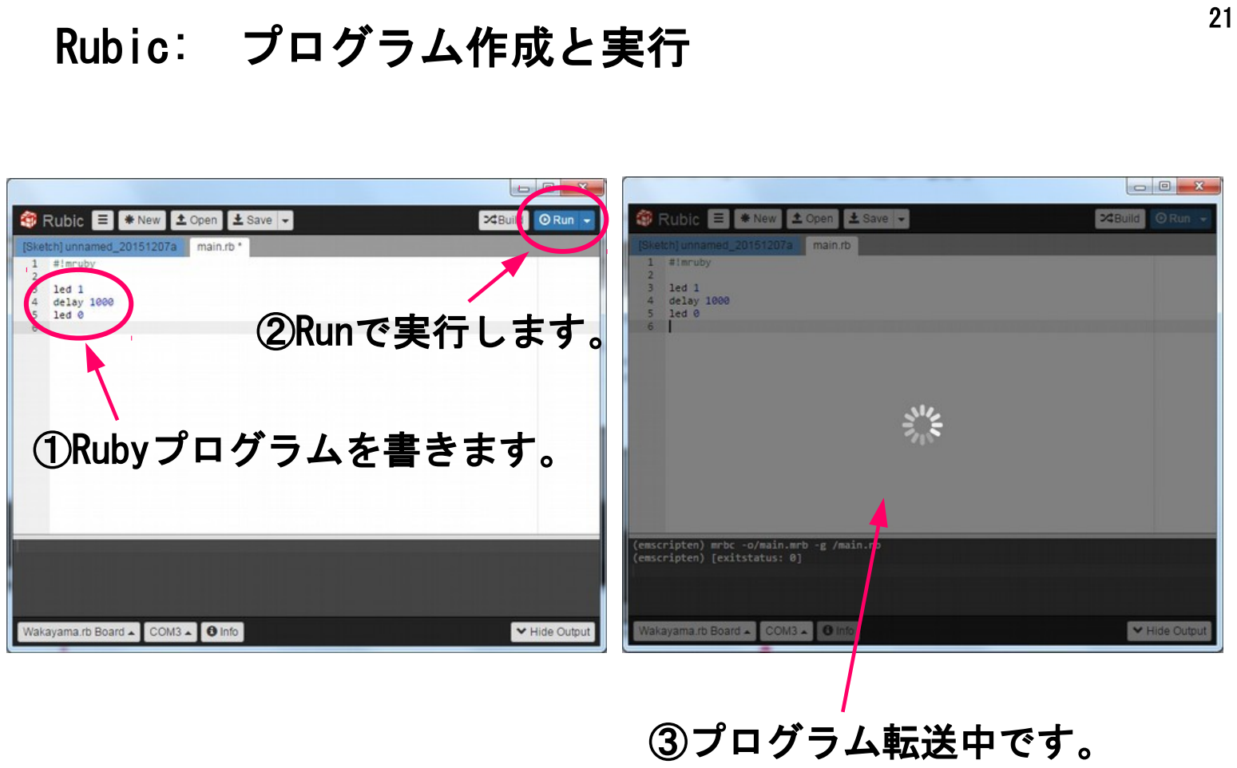
[picture p61: page 21]

## ①Rubyプログラムを書きます。

## ②Runで実行します。

## ③プログラム転送中です。

## Rubic: プログラム作成と実行

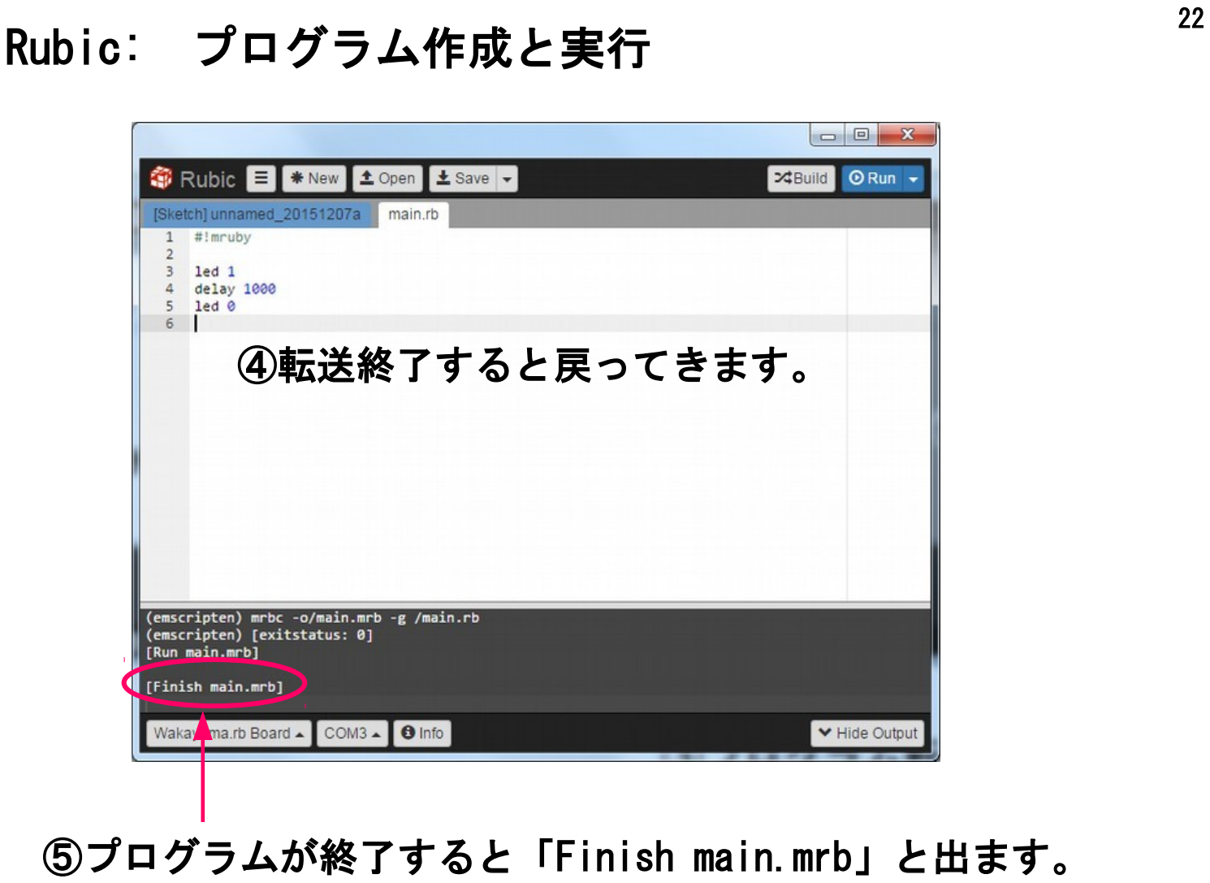
[picture p62: page 22]

## ④転送終了すると戻ってきます。

## ⑤プログラムが終了すると「Finish main.mrb」と出ます。

## Rubic: プログラムの保存

## ①Save▼をクリックしてSave as...を選択します。

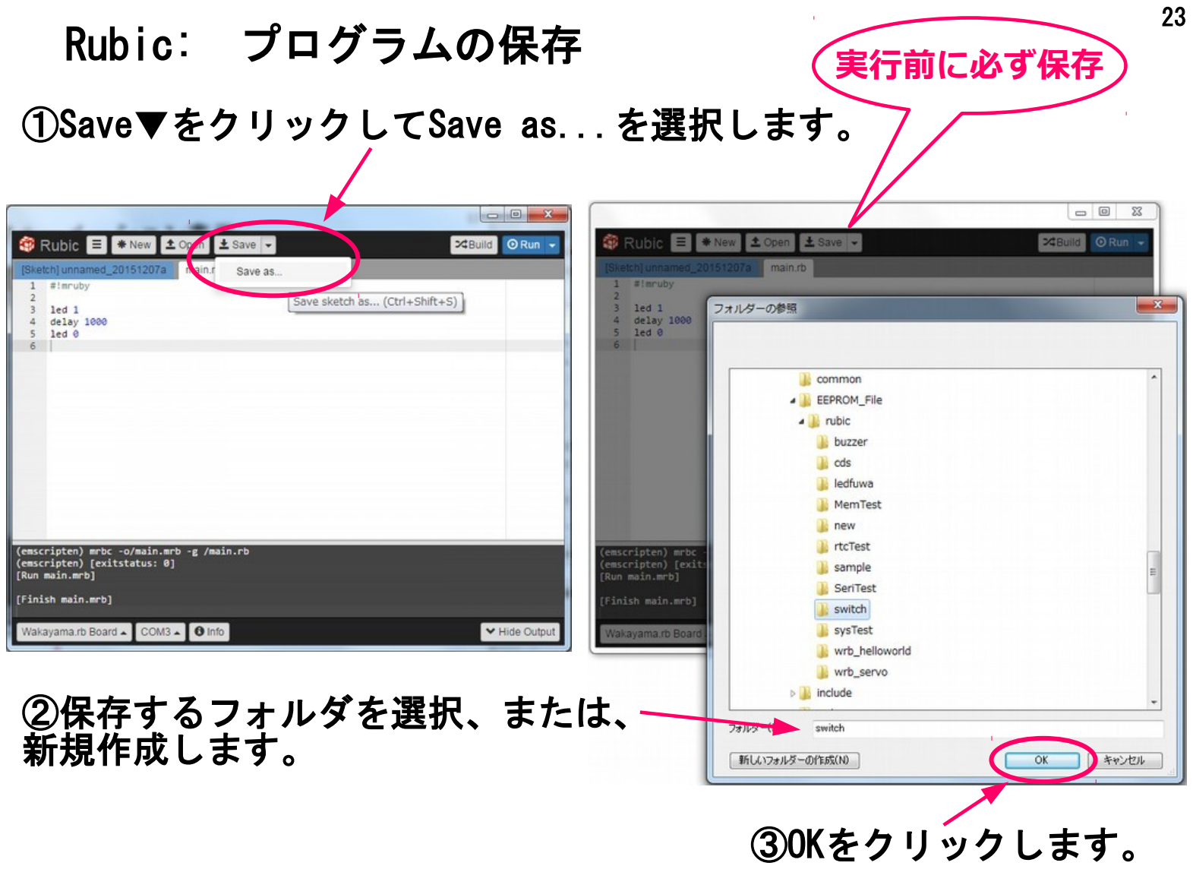
[picture p63: page 23]

## ②保存するフォルダを選択、または、 新規作成します。

## ③OKをクリックします。

# 実行前に必ず保存

## Rubic: プログラムの読込み

## ①Openをクリックしてフォルダ一覧を出します。

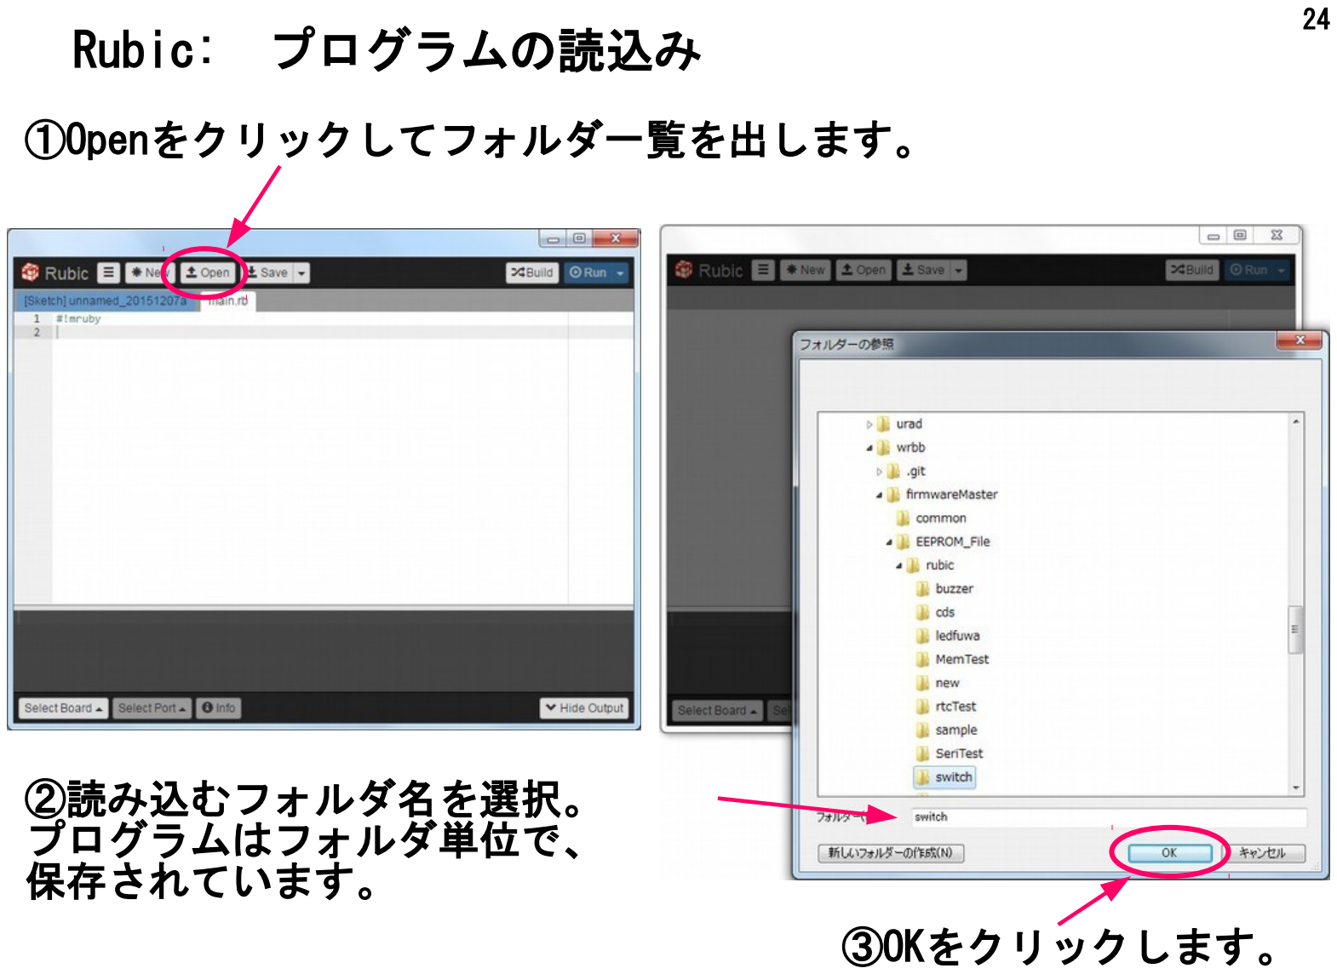
[picture p64: page 24]

## ②読み込むフォルダ名を選択。 プログラムはフォルダ単位で、 保存されています。 ③OKをクリックします。

## Rubic: プログラムの読込み

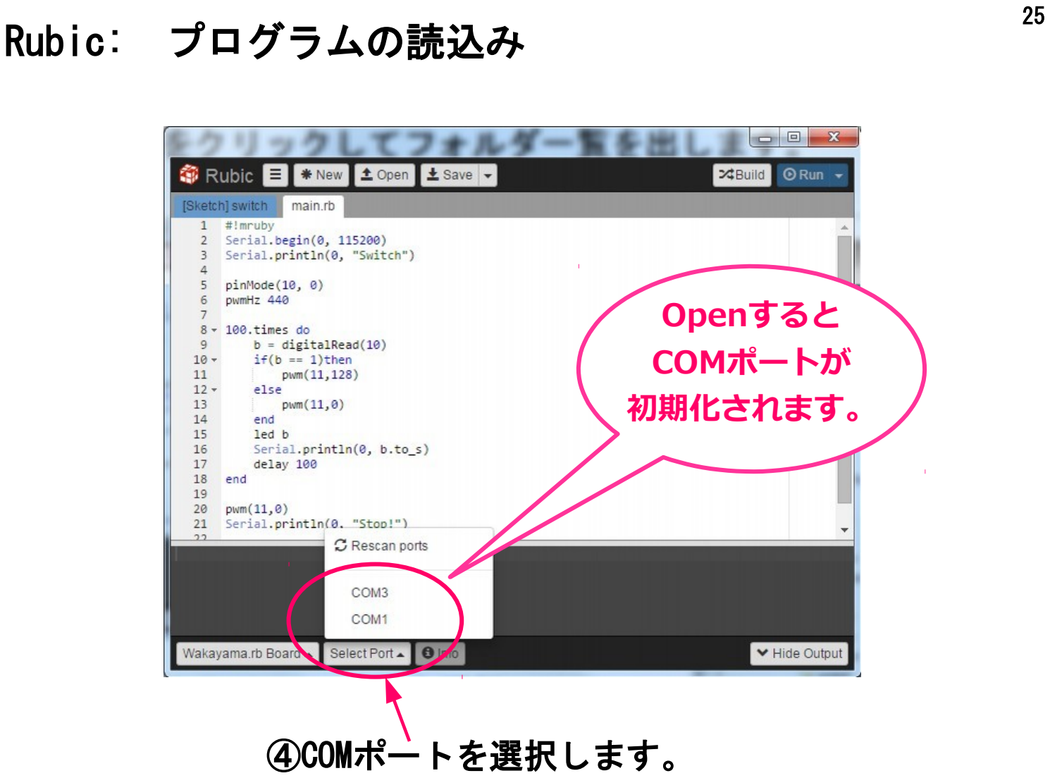
[picture p65: page 25]

## ④COMポートを選択します。

# Openすると COMポートが 初期化されます。

## Rubic: フリーズしたときの復帰

## ここでマウスの

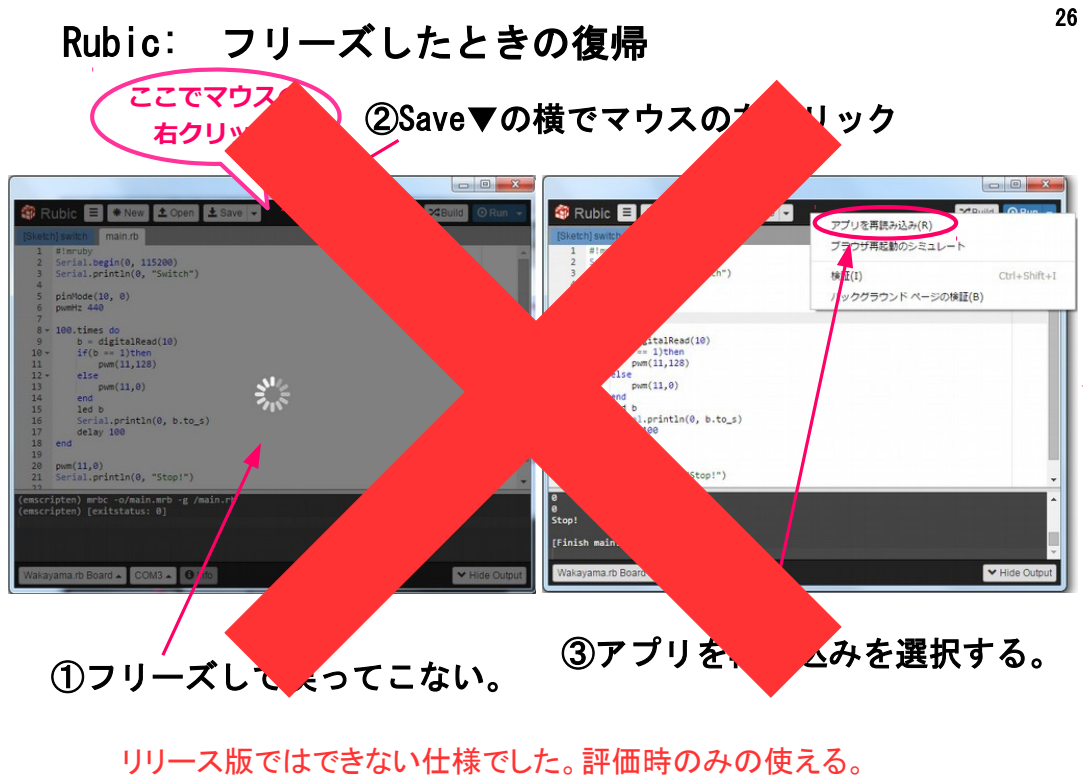
[picture p66: page 26]
①フリーズして戻ってこない。; 右クリック; ②Save▼の横でマウスの右クリック; ③アプリを再読込みを選択する。; リリース版ではできない仕様でした。評価時のみの使える。

# ハンズオン

## 1.LEDチカチカ

# #!mruby

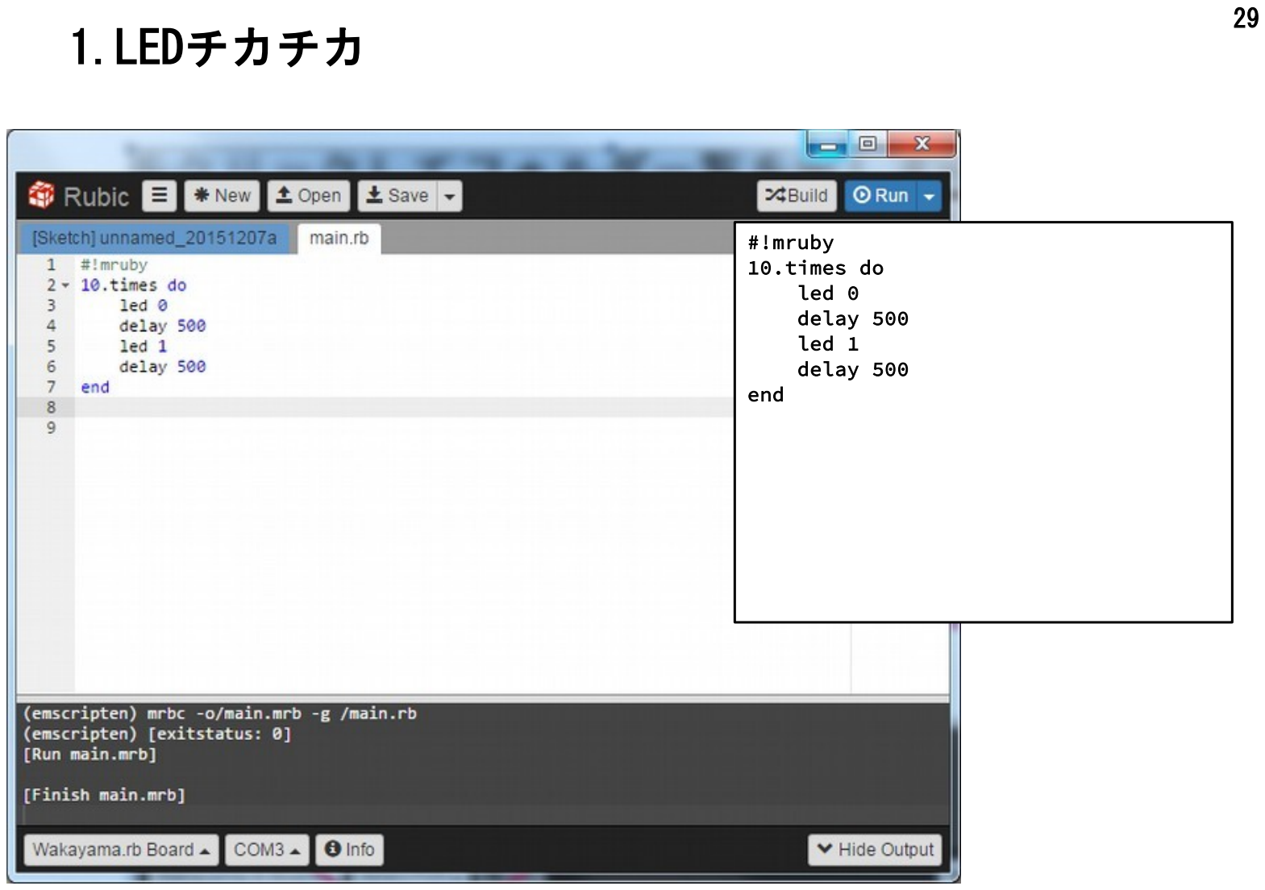
[picture p67: page 29]

# 10.times do led 0 delay 500 led 1 delay 500 end

## 2.Hello World!と LEDチカチカ

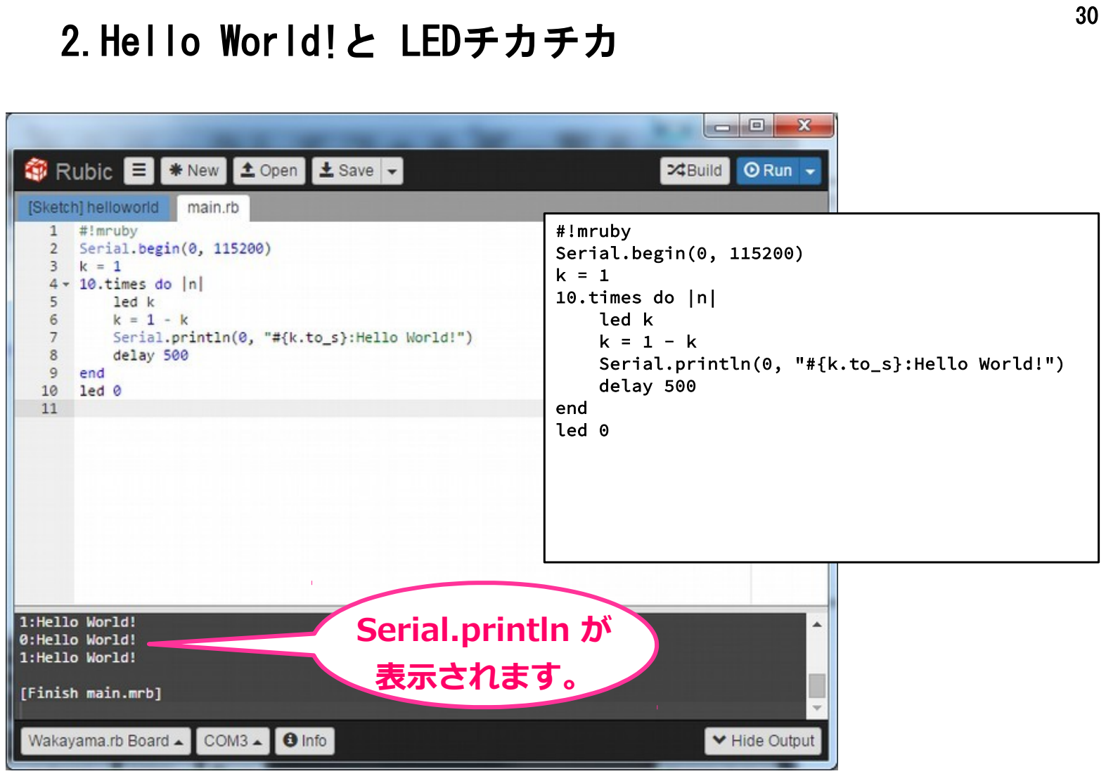
[picture p68: page 30]

# !mruby Serial.begin(0, 115200)

k = 1

# 10.times do |n| led k

k = 1 - k

# Serial.println(0, "#{k.to_s}:Hello World!") delay 500 end led 0

# Serial.println が 表示されます。

## 3.スイッチ

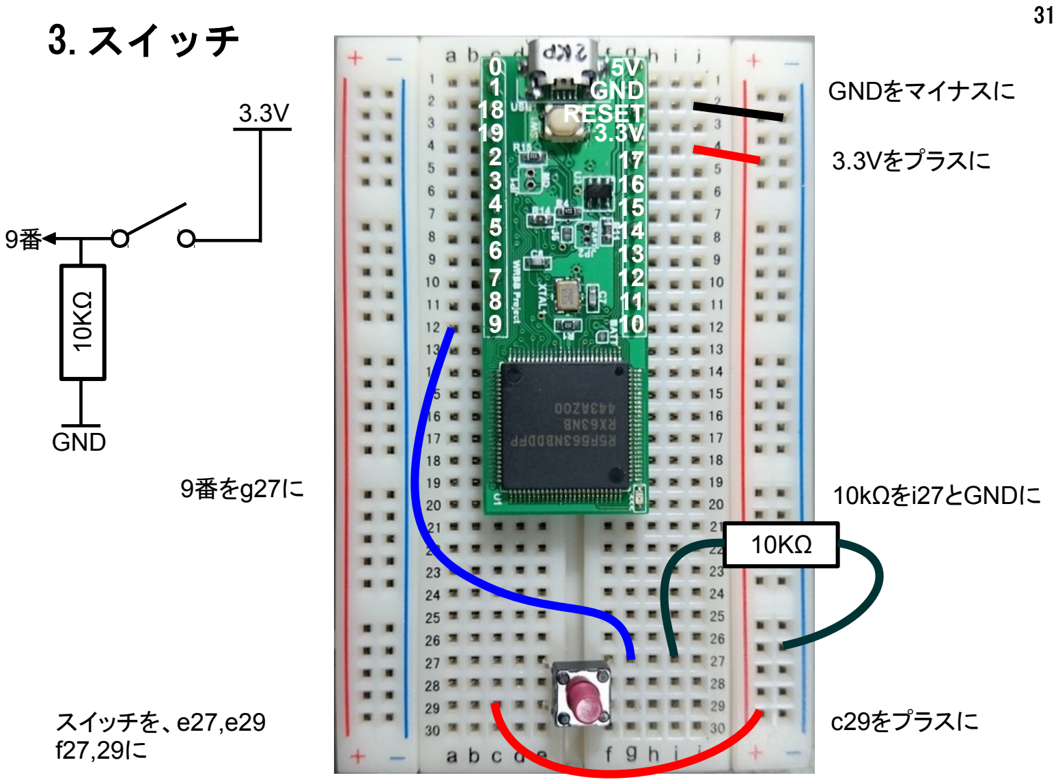
[picture p69: page 31]

3.3V

3.3Vをプラスに

GNDをマイナスに

スイッチを、e27,e29
f27,29に

c29をプラスに

GND

5V

3.3V

13
12
11
9 10

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
RESET

9番をg27に

10KΩ

10kΩをi27とGNDに

9番

GND

1

0

K

Ω

## 3.スイッチ

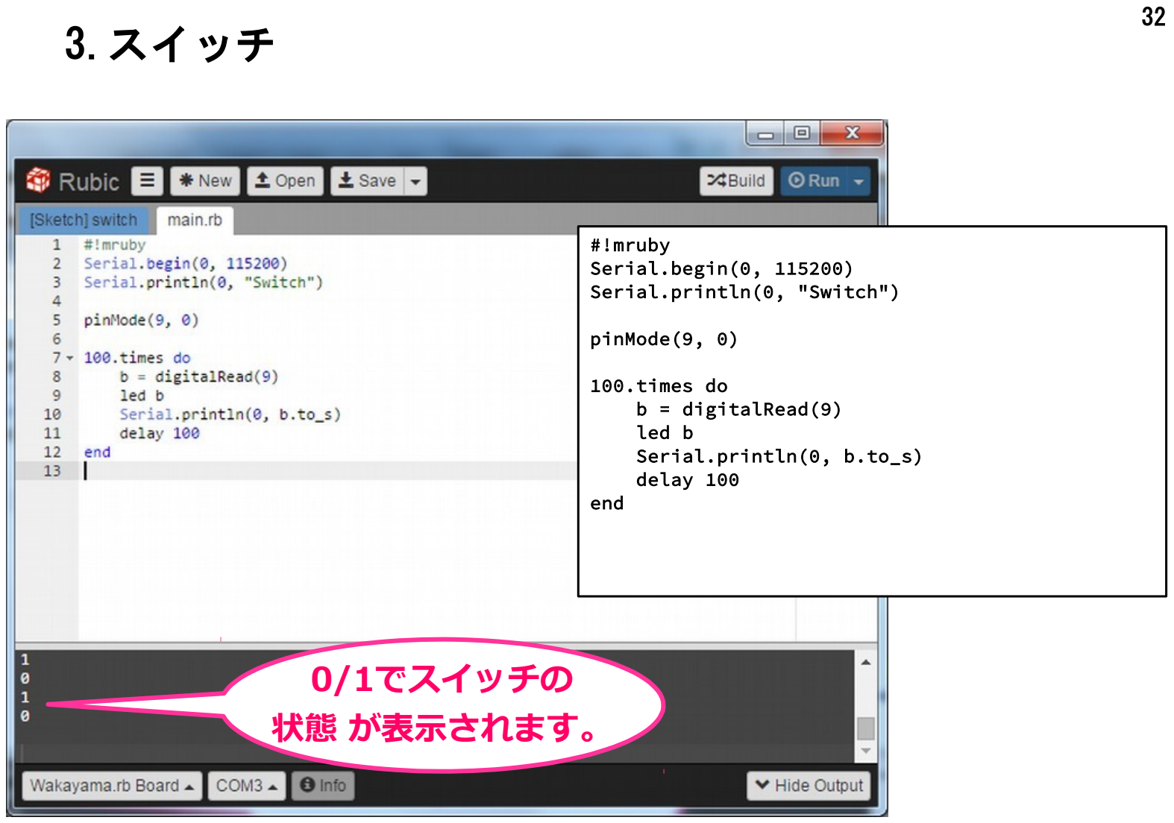
[picture p70: page 32]

# !mruby Serial.begin(0, 115200) Serial.println(0, "Switch") pinMode(9, 0) 100.times do b = digitalRead(9) led b Serial.println(0, b.to_s) delay 100 end

# 0/1でスイッチの 状態 が表示されます。

## 4.ブザー

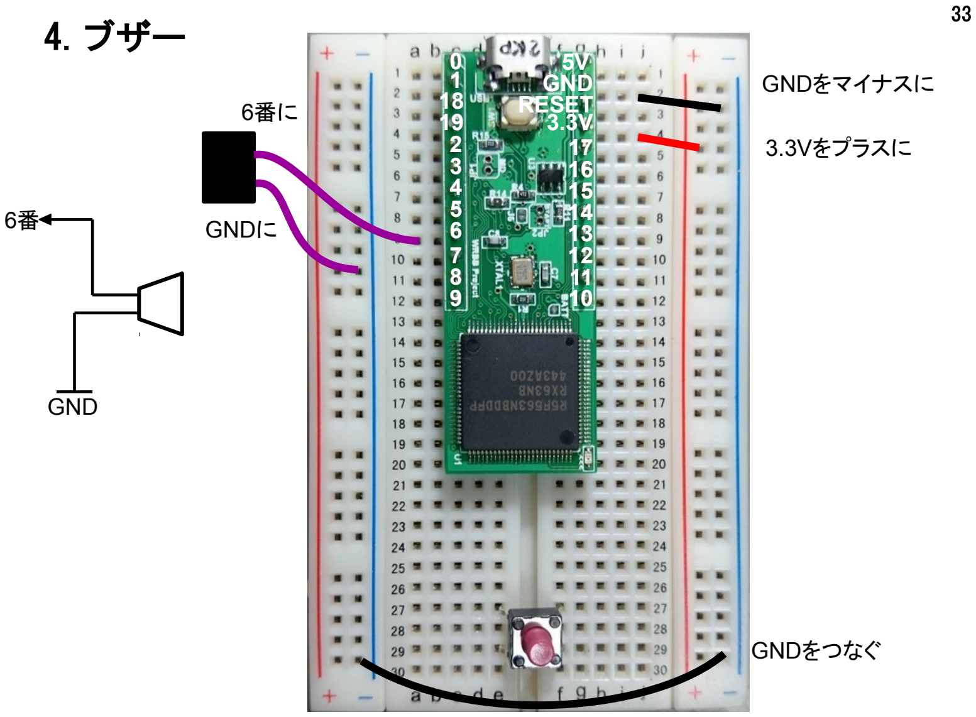
[picture p71: page 33]

3.3Vをプラスに

GNDをマイナスに

GNDをつなぐ

GND

5V

3.3V

13
12
11
9 10

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
RESET 6番に

6番

GND

GNDに

## 4.ブザー

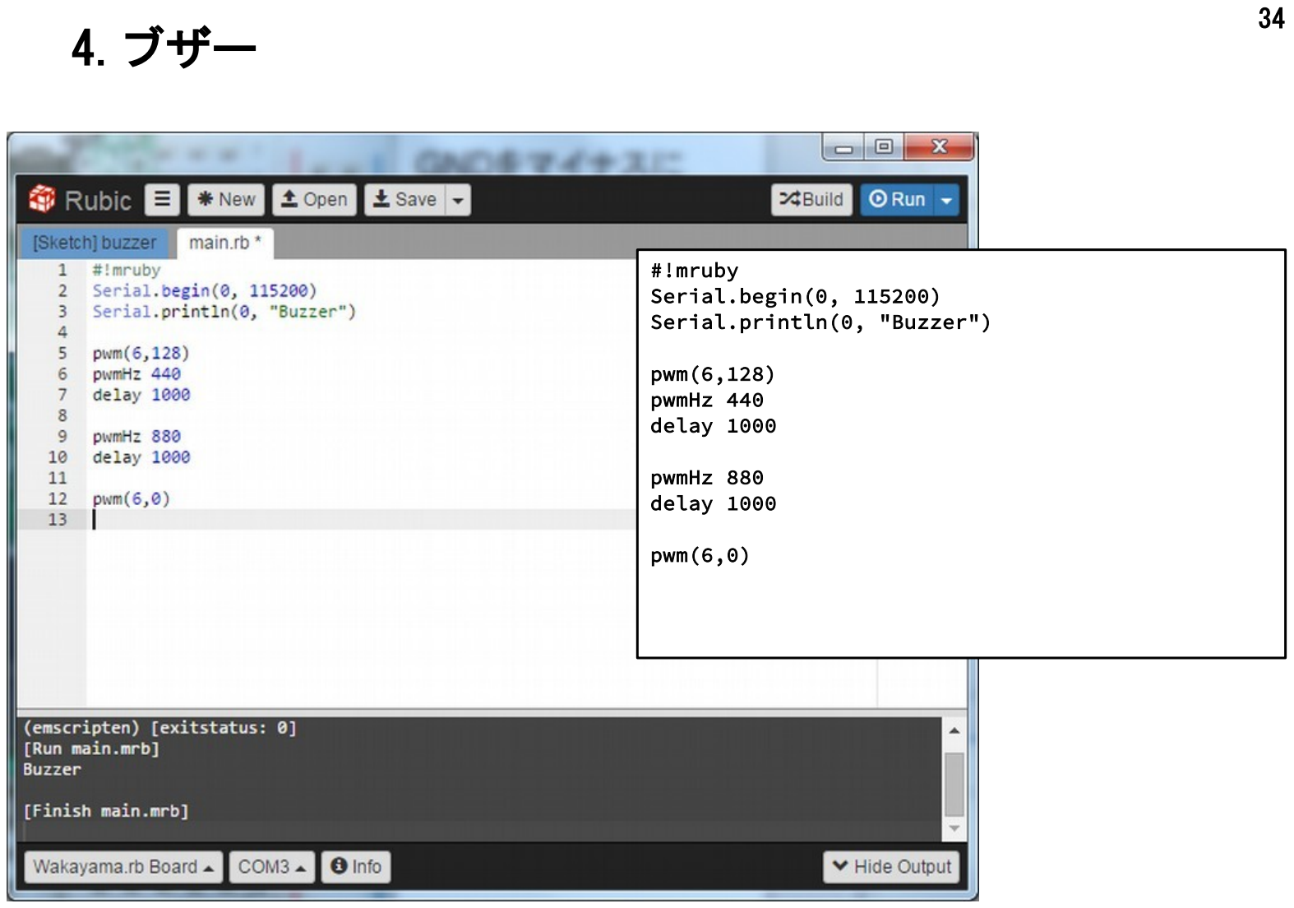
[picture p72: page 34]

# !mruby Serial.begin(0, 115200) Serial.println(0, "Buzzer") pwm(6,128) pwmHz 440 delay 1000 pwmHz 880 delay 1000 pwm(6,0)

## 5.ブザーとスイッチ

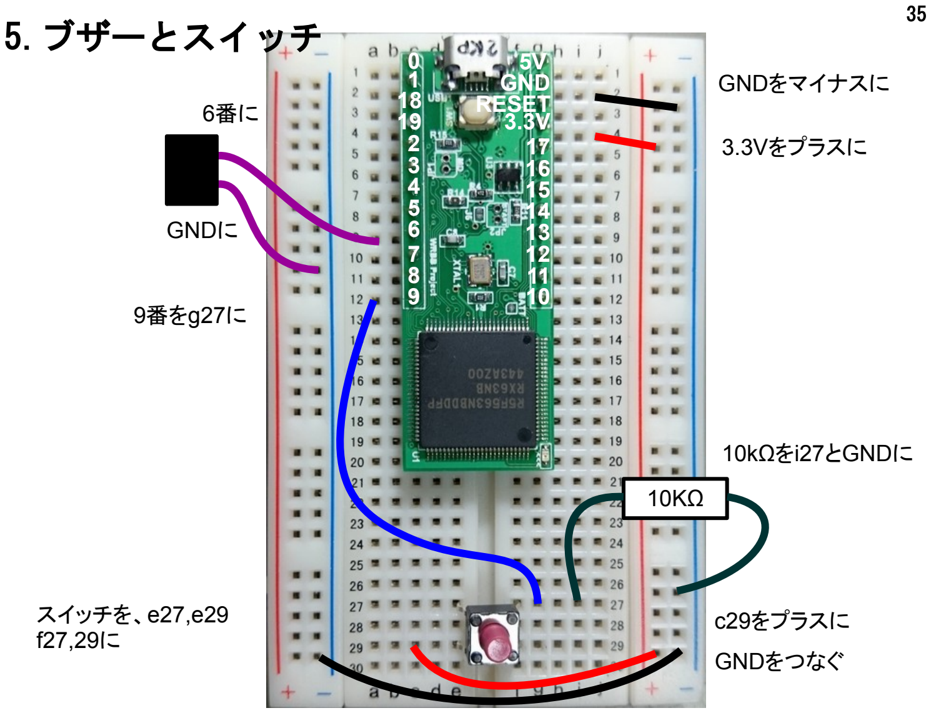
[picture p73: page 35]

3.3Vをプラスに

GNDをマイナスに

スイッチを、e27,e29
f27,29に

c29をプラスに

GND

5V

3.3V

13
12
11
9 10

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
RESET

9番をg27に

10KΩ

10kΩをi27とGNDに

6番に

GNDに

GNDをつなぐ

## 5.ブザーとスイッチ

# #!mruby

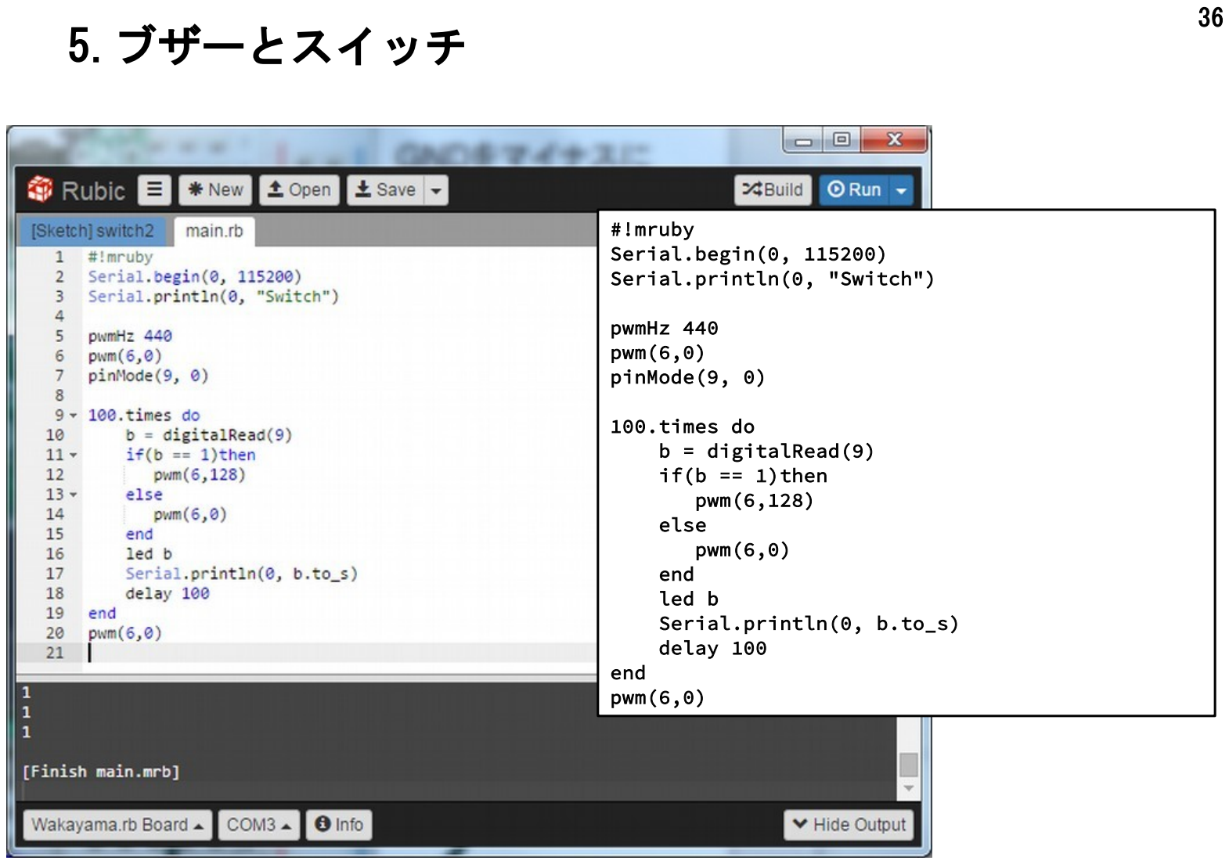
[picture p74: page 36]

# Serial.begin(0, 115200) Serial.println(0, "Switch") pwmHz 440 pwm(6,0) pinMode(9, 0) 100.times do b = digitalRead(9) if(b == 1)then pwm(6,128) else pwm(6,0) end led b Serial.println(0, b.to_s) delay 100 end pwm(6,0)

## 6.光センサとAD変換

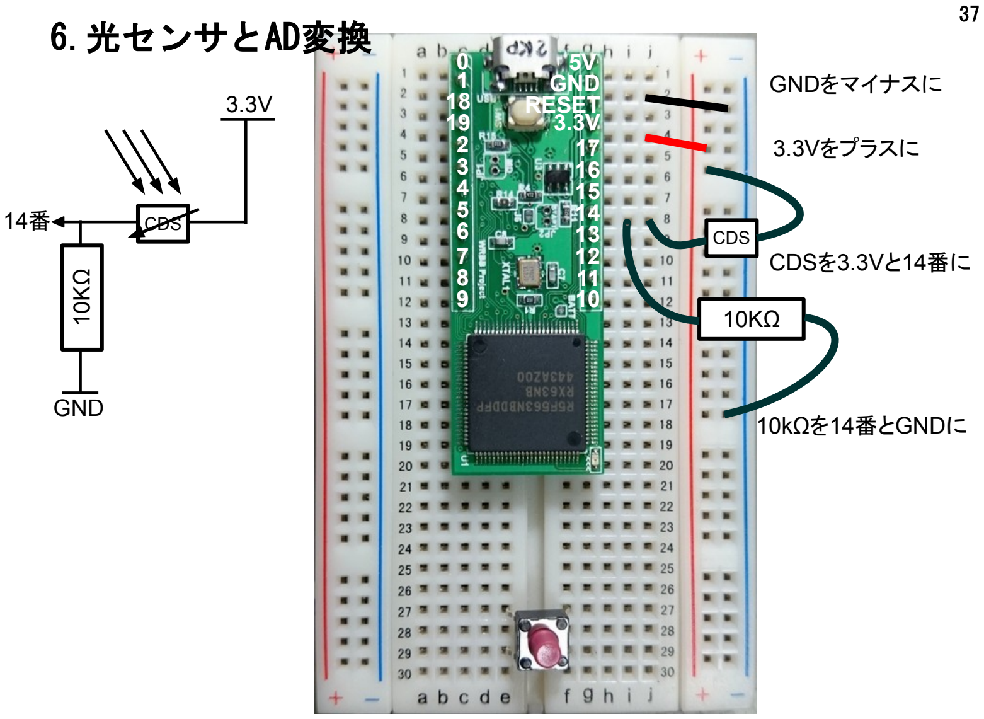
[picture p75: page 37]

3.3V

3.3Vをプラスに

GND | GNDをマイナスに

5V

3.3V

13
12
11

9 10 8765432

19

1810

14

15

16

17

RESET

10KΩ

10kΩ

を14番とGND
に

14
番

# GND¹⁰KΩ

CDS
CDS
CDS

を3.3V

と14番に

# #!mruby

## 6.光センサとAD変換

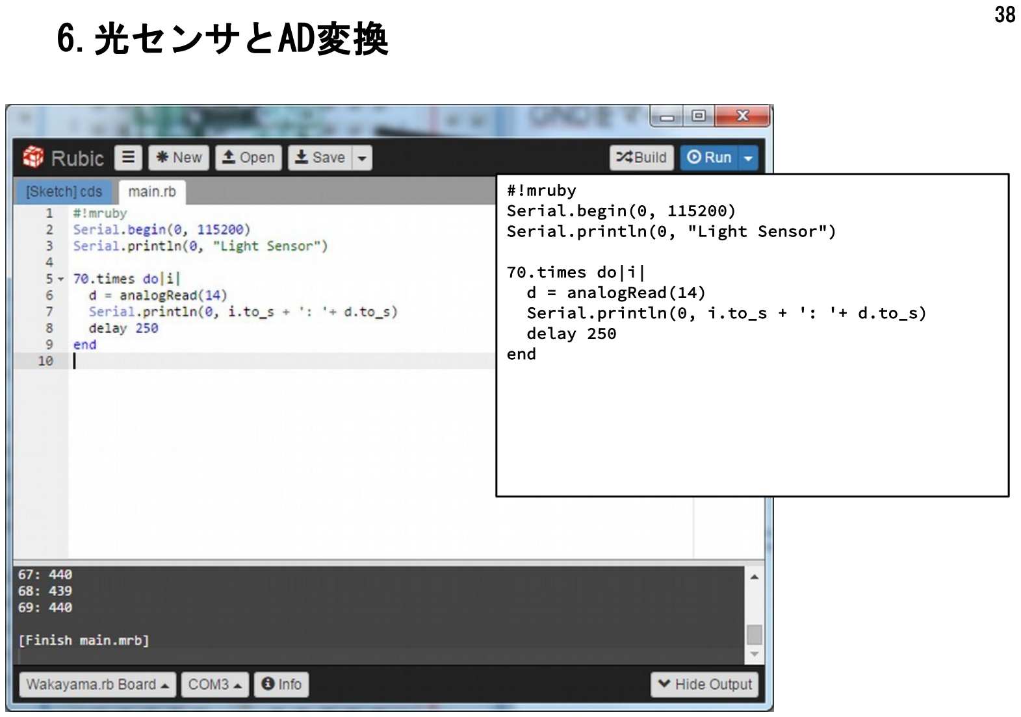
[picture p76: page 38]

# Serial.begin(0, 115200) Serial.println(0, "Light Sensor") 70.times do|i| d = analogRead(14) Serial.println(0, i.to_s + ': '+ d.to_s) delay 250 end

## 7.光センサとAD変換2

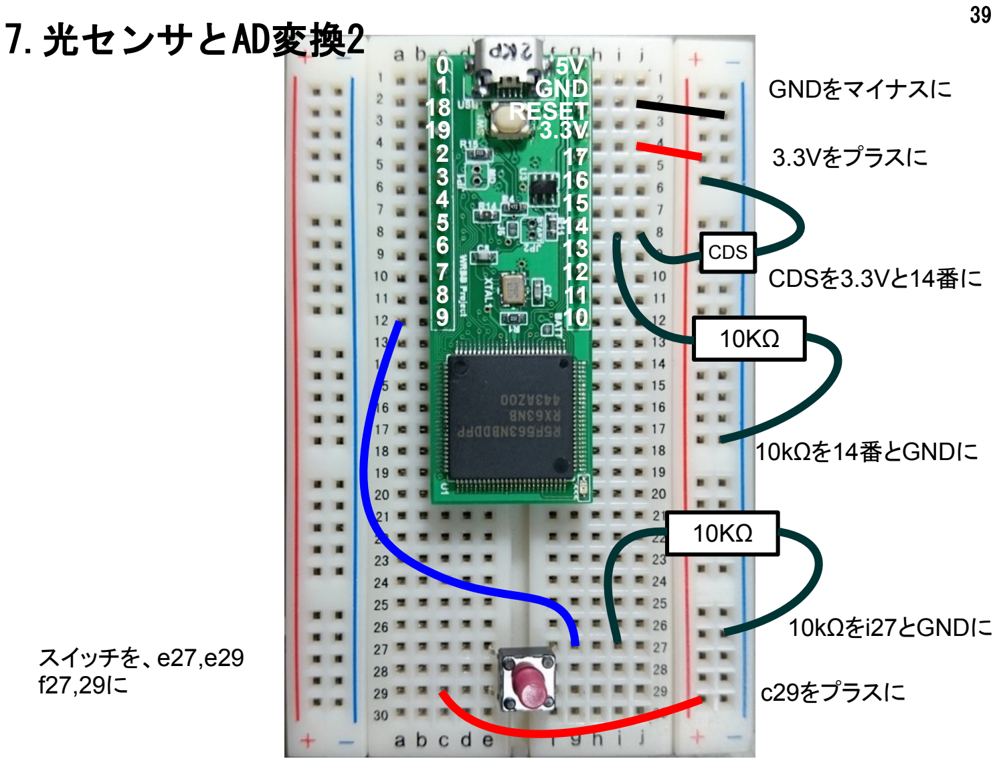
[picture p77: page 39]

3.3Vをプラスに

GND | GNDをマイナスに

5V

3.3V

13
12
11
9 10

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
RESET

10KΩ

10kΩを14番とGNDに

CDS
CDSを3.3Vと14番に

スイッチを、e27,e29
f27,29に | c29をプラスに

10KΩ

10kΩをi27とGNDに

# #!mruby

## 7.光センサとAD変換2

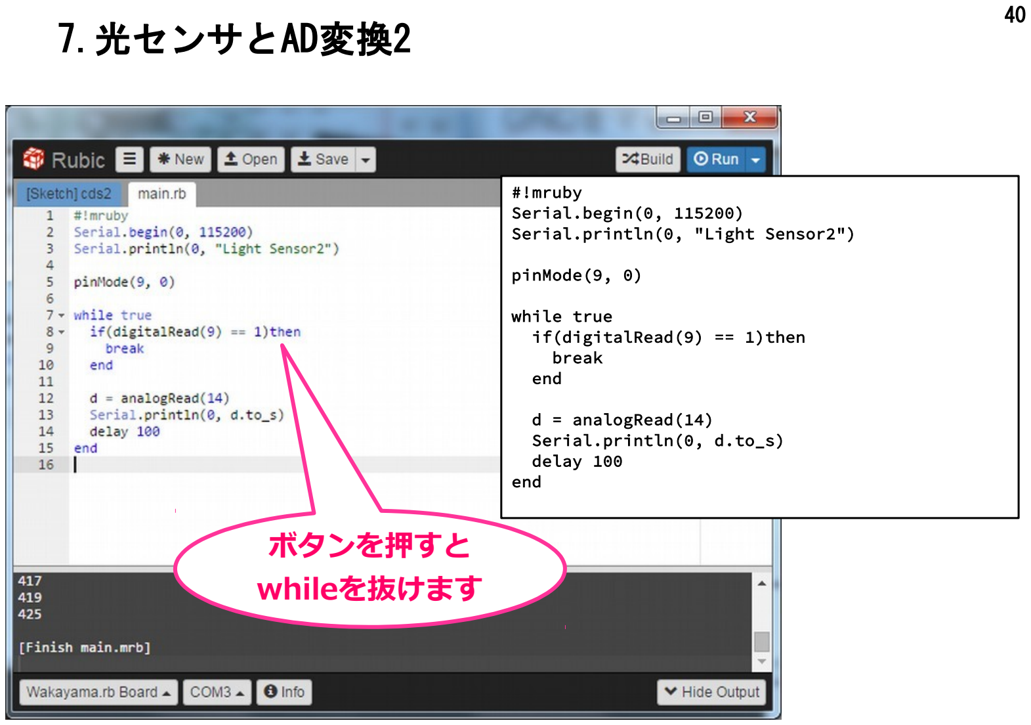
[picture p78: page 40]

# Serial.begin(0, 115200) Serial.println(0, "Light Sensor2") pinMode(9, 0) while true if(digitalRead(9) == 1)then break end d = analogRead(14) Serial.println(0, d.to_s) delay 100 end

# ボタンを押すと whileを抜けます

## 8.光センサとブザー

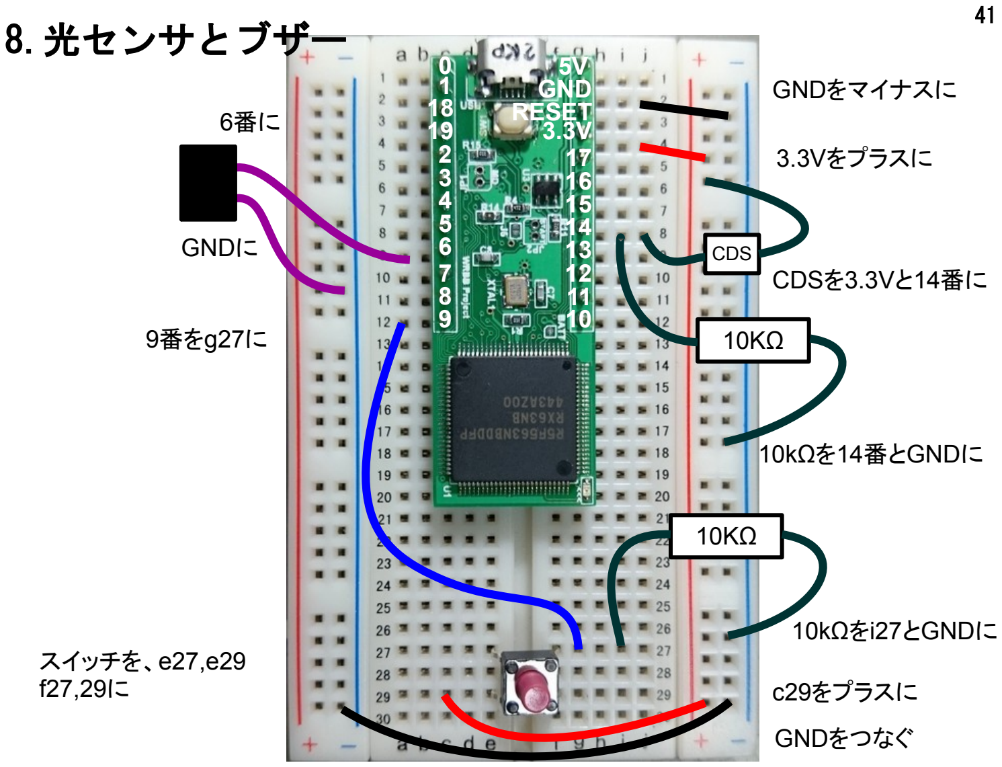
[picture p79: page 41]

3.3Vをプラスに

GND | GNDをマイナスに

5V

3.3V

13
12
11
9 10

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
RESET

10KΩ

10kΩを14番とGNDに

CDS
CDSを3.3Vと14番に

スイッチを、e27,e29
f27,29に

10KΩ

10kΩをi27とGNDに

9番をg27に

6番に

GNDに

c29をプラスに

GNDをつなぐ

# #!mruby

## 8.光センサとブザー

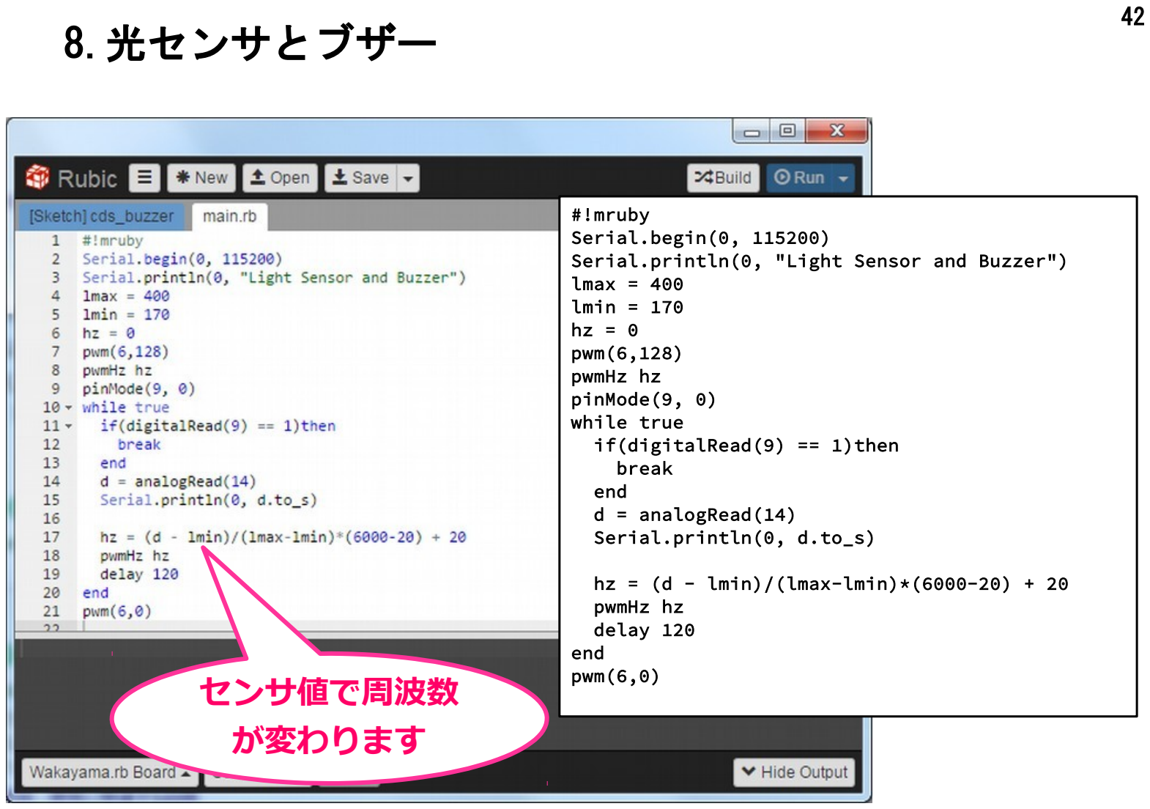
[picture p80: page 42]

# Serial.begin(0, 115200) Serial.println(0, "Light Sensor and Buzzer") lmax = 400 lmin = 170

hz = 0

# pwm(6,128) pwmHz hz pinMode(9, 0) while true if(digitalRead(9) == 1)then break end d = analogRead(14) Serial.println(0, d.to_s) hz = (d - lmin)/(lmax-lmin)*(6000-20) + 20 pwmHz hz delay 120 end pwm(6,0)

# センサ値で周波数 が変わります

# ソースプログラムの入手方法

## Wakayama.rbボードの基本プログラムは、githubでオープ ンソースとして、すべて公開されています。 makeしたプログラムはwrbb.motです。

## Wakayama.rbボードへのwrbb.motファイルの書き込み方法 は、下記URLのブログに公開しています。

## http://d.hatena.ne.jp/tarosay/20151123/1448301501

## https://github.com/tarosay/Wakayama-mruby-board/

tree/master/wrbb_firmware/EEPROM_File/rubic (https://github.com/tarosay/Wakayama-mruby-board/tree/master/wrbb_firmware/EEPROM_File/rubic)

## ハンズオンに用いたプログラムは、下記URLにあります。

## https://github.com/tarosay/Wakayama-mruby-board

## 今回使用した基板は、WRBB4ファームが動作しているも のです。Ver.4.0基板です。

以上

# ありがとうございました。 お疲れさまでした。

### 毎月勉強会を開いています。是非、Wakayama.rbに参加してください。

## https://wakayamarb.doorkeeper.jp/
