tarosay/Wakayama-mruby-board/拡張ボード類/WRBB-WF基板.pdf

# WRBB-SDWF Ver1.0基板 説明資料

### 山本三七男

# WRBB-SDWF基板

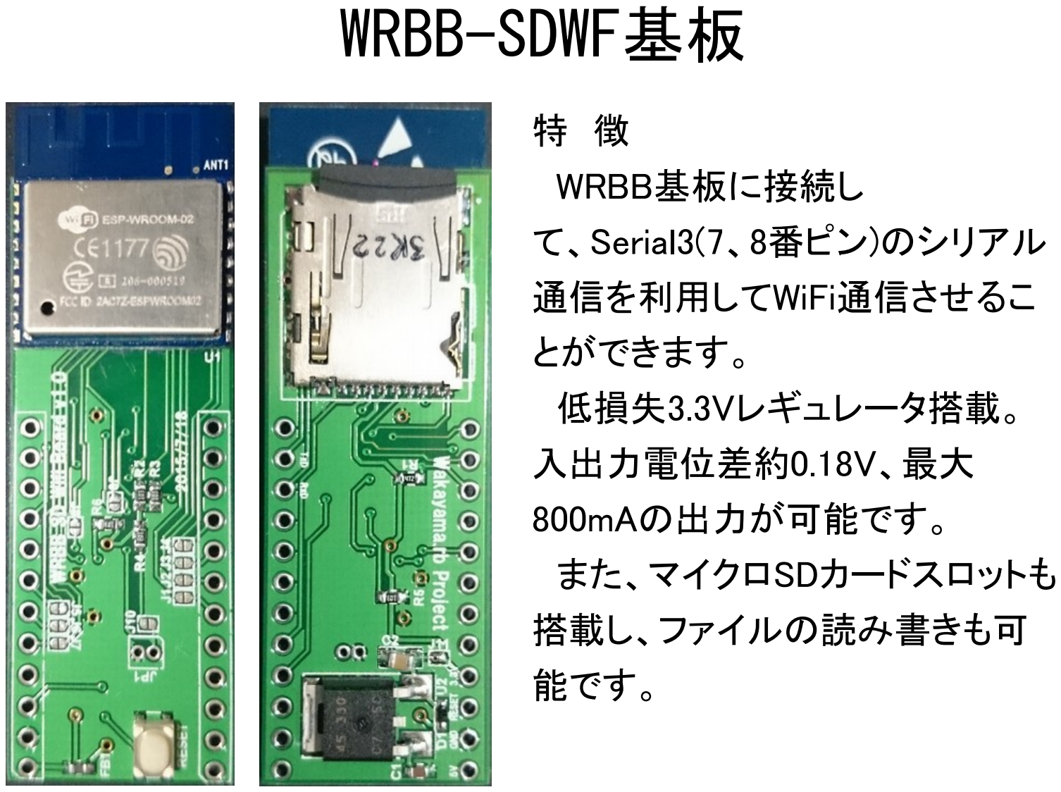
[picture p121: page 2]

特　徴
WRBB基板に接続し
て、Serial3(7、8番ピン)のシリアル
通信を利用してWiFi通信させるこ
とができます。
低損失3.3Vレギュレータ搭載。
入出力電位差約0.18V、最大
800mAの出力が可能です。
また、マイクロSDカードスロットも
搭載し、ファイルの読み書きも可
能です。

WiFi基板
ESP-WROOM-02
(ESP8266/Espressif Systems社製)

レギュレータ
NJM2845DL1-33(新日本無線社製)
電圧3.3V、最大800mA
入出力電位差 約0.18V
入力最大定格 14V

# WRBB-SDWF基板

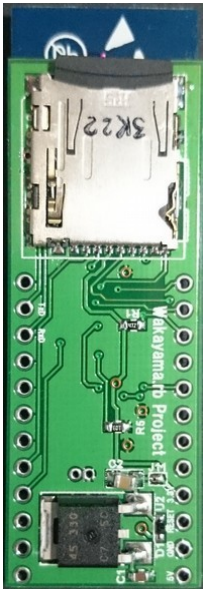
[picture p122: figure]
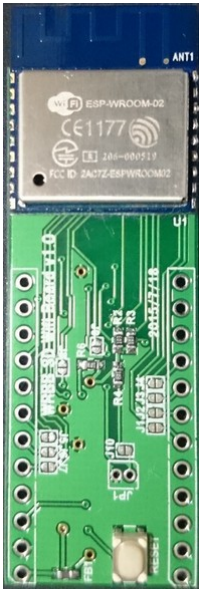
[picture p123: figure]

表 | 裏

# ピンアサイン

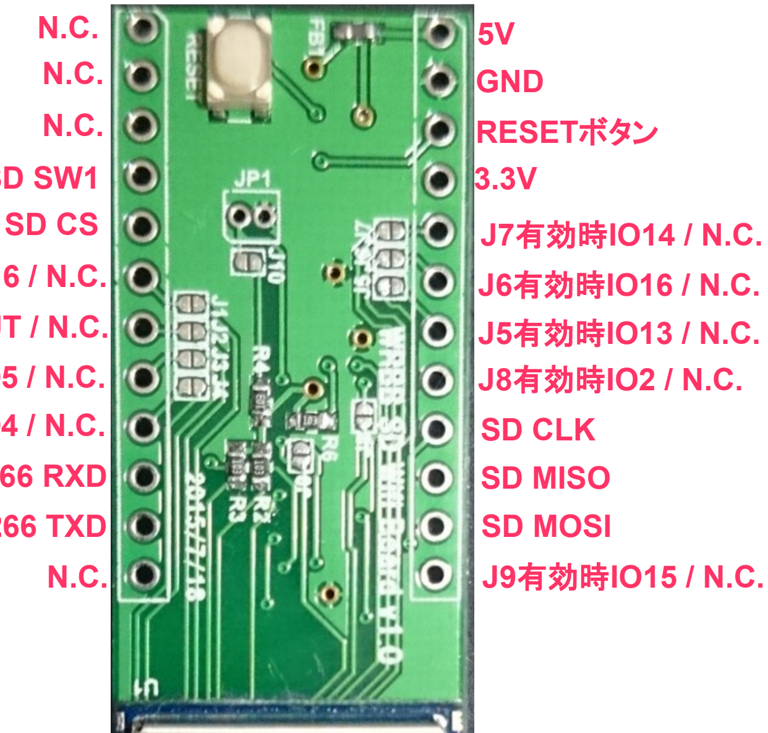
[picture p124: figure]
J7有効時IO14 / N.C.; J6有効時IO16 / N.C. J5有効時IO13 / N.C. J8有効時IO2 / N.C. SD CLK SD MISO SD MOSI J9有効時IO15 / N.C.

RESETボタン

GND

5V

3.3V

ESP8266 TXD

J2有効時TOUT / N.C.
J3有効時IO5 / N.C.

N.C.

N.C.

N.C.

N.C.

J1有効時IO16 / N.C.

J4有効時IO4 / N.C.
ESP8266 RXD

SD SW1

# ジャンパの説明

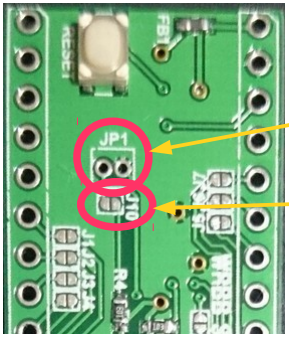
[picture p125: figure]

J1～J9

J10

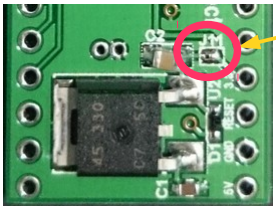
[picture p126: figure]

J11

JP1

オンにすると、ピンに接続するのでIOを有効
に利用することができます。

常にオンにしておく。
プルアップされてESP8266がフラッシュブート
モードとなる。

オンにすると、ESP8266がUARTダウンロード
モードとなり、ファームの書き換えができる。

オンにすると、レギュレータの3.3V出力が回路
の3.3Vに接続され、レギュレータによる電力供
給が可能となる。

# 基板補足説明

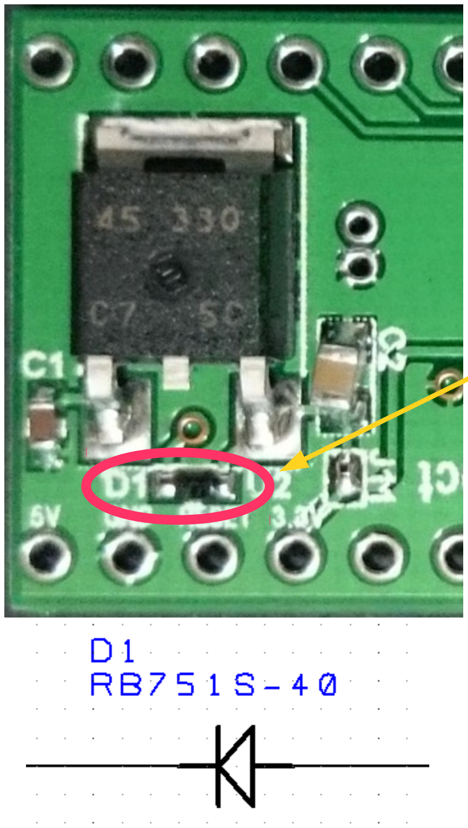
[picture p127: figure]

D1

保護ダイオードRB751S-40は、D1の文字側が
カソードです。
