tarosay/Wakayama-mruby-board/拡張ボード類/WRB-SDWF (rsbom).xlsx

Report File: | D:\git\bitbucket\wrbb\Schematic\DesginSpark7\SDWFShield\WRB-SDWF (rsbom).csv
Report Written: | Tuesday, August 25, 2015
Design Path: | D:\git\bitbucket\wrbb\Schematic\DesginSpark7\SDWFShield\WRB-SDWF.sch
Design Title:
Created:
Last Saved: | 2015-08-25 04:55
Editing Time: | 8386 min
Units: | mm (precision 3)
Bill of Materials generated with DesignSpark PCB - www.DesignSpark.com/pcb
--------------------------------------------------------------------------
Ref Name | Qty | Component | Value | Package | Manufacturer | MPN | RS Part Number | Other Part Number | Description
V11 | 1 | +3.3V
V12 | 1 | +3.3V
V15 | 1 | +5V
V17 | 1 | +5V
V18 | 1 | +5V
V19 | 1 | +5V
V20 | 1 | +5V
V5 | 1 | +5V
V6 | 1 | +5V
V21 | 1 | +5V
C1 | 1 | C1608 | 0.33uF | DIL
C2 | 1 | C2012 | 10uF | DIL
JP1 | 1 | CONN2Half |  | DIL
CONN2 | 1 | CONN12 |  | DIL
CONN1 | 1 | CONN12 |  | DIL
U1 | 1 | ESP8266-WROOM-02 |  | SM
FB1 | 1 | FB(1608) |  | SM
REF6 | 1 | GND |  |  |  |  |  |  | Power
REF10 | 1 | GND |  |  |  |  |  |  | Power
REF11 | 1 | GND |  |  |  |  |  |  | Power
REF27 | 1 | GND |  |  |  |  |  |  | Power
REF28 | 1 | GND |  |  |  |  |  |  | Power
REF29 | 1 | GND |  |  |  |  |  |  | Power
REF31 | 1 | GND |  |  |  |  |  |  | Power
REF9 | 1 | GND |  |  |  |  |  |  | Power
REF32 | 1 | GND |  |  |  |  |  |  | Power
J9 | 1 | JPbridge |  | SM
J8 | 1 | JPbridge |  | SM
J10 | 1 | JPbridge |  | SM
J1 | 1 | JPbridge |  | SM
J2 | 1 | JPbridge |  | SM
J3 | 1 | JPbridge |  | SM
J4 | 1 | JPbridge |  | SM
J7 | 1 | JPbridge |  | SM
J6 | 1 | JPbridge |  | SM
J5 | 1 | JPbridge |  | SM
J11 | 1 | JPbridge |  | SM
CONN3 | 1 | microSD_DM3AT-SF-PEJM5 |  | SM
U2 | 1 | NJM2845DL1-33 |  | DIL
R1 | 1 | R1608 | 4.7K | DIL
R2 | 1 | R1608 | 10K | DIL
R3 | 1 | R1608 | 10K | DIL
R4 | 1 | R1608 | 10K | DIL
R5 | 1 | R1608 | 10K | DIL
R6 | 1 | R1608 | 10K | DIL
D1 | 1 | RB751S-40 |  | SM
SW1 | 1 | SW_SKRPACE010 |  | SM | RESET
