tarosay/Wakayama-mruby-board/(threads)

Thread 2 (2019-08-23):

RUBIC-Jには著作物保護機構がついていていてワンピース２０巻セット3980円とかで売れるんです。

JFLABO, 2019-08-23:
USBでさすと読めます。保護機構のROMをコピーしようとすると
日本国内著作権で保護されています。とでて
http://jflabo.org/pay/
こんな画面が出ます。

映画もシティーハンター全巻セットも売れますよ〜

JFLABO, 2019-08-23:
これをそこにさすと、ガンダムが見れる　という状態に仕上げて
　小学生向けに調整
USBメモリカバーにイラストをプリントして買ってもらうとか

JFLABO, 2019-08-23:
ダウンロード待ちで１時間経過　とかならないですね

JFLABO, 2019-08-23:
have fun anyway!!

JFLABO, 2019-08-23:
http://jflabo.org/lucky.php
これの中にも入れられますね

JFLABO, 2019-08-23:
それのなかにあれをいれよう　みたいな感じで開発してます
http://jflabo.org/lucky.php

Thread 3 (2019-09-01):

ビジセス商材企画部　

JFLABO, 2019-09-01:
https://github.com/JFLABO/rubyex/blob/master/electro-devices-RUBIC-J-gogole%E4%BD%BF%E3%81%84%E6%96%B9%E3%83%9E%E3%83%8B%E3%83%A5%E3%82%A2%E3%83%AB-7%20(2).pdf　リファレンスモデル
