tarosay/Wakayama-mruby-board/Schematic/Wakayamarb5_2 - Schematic.pdf

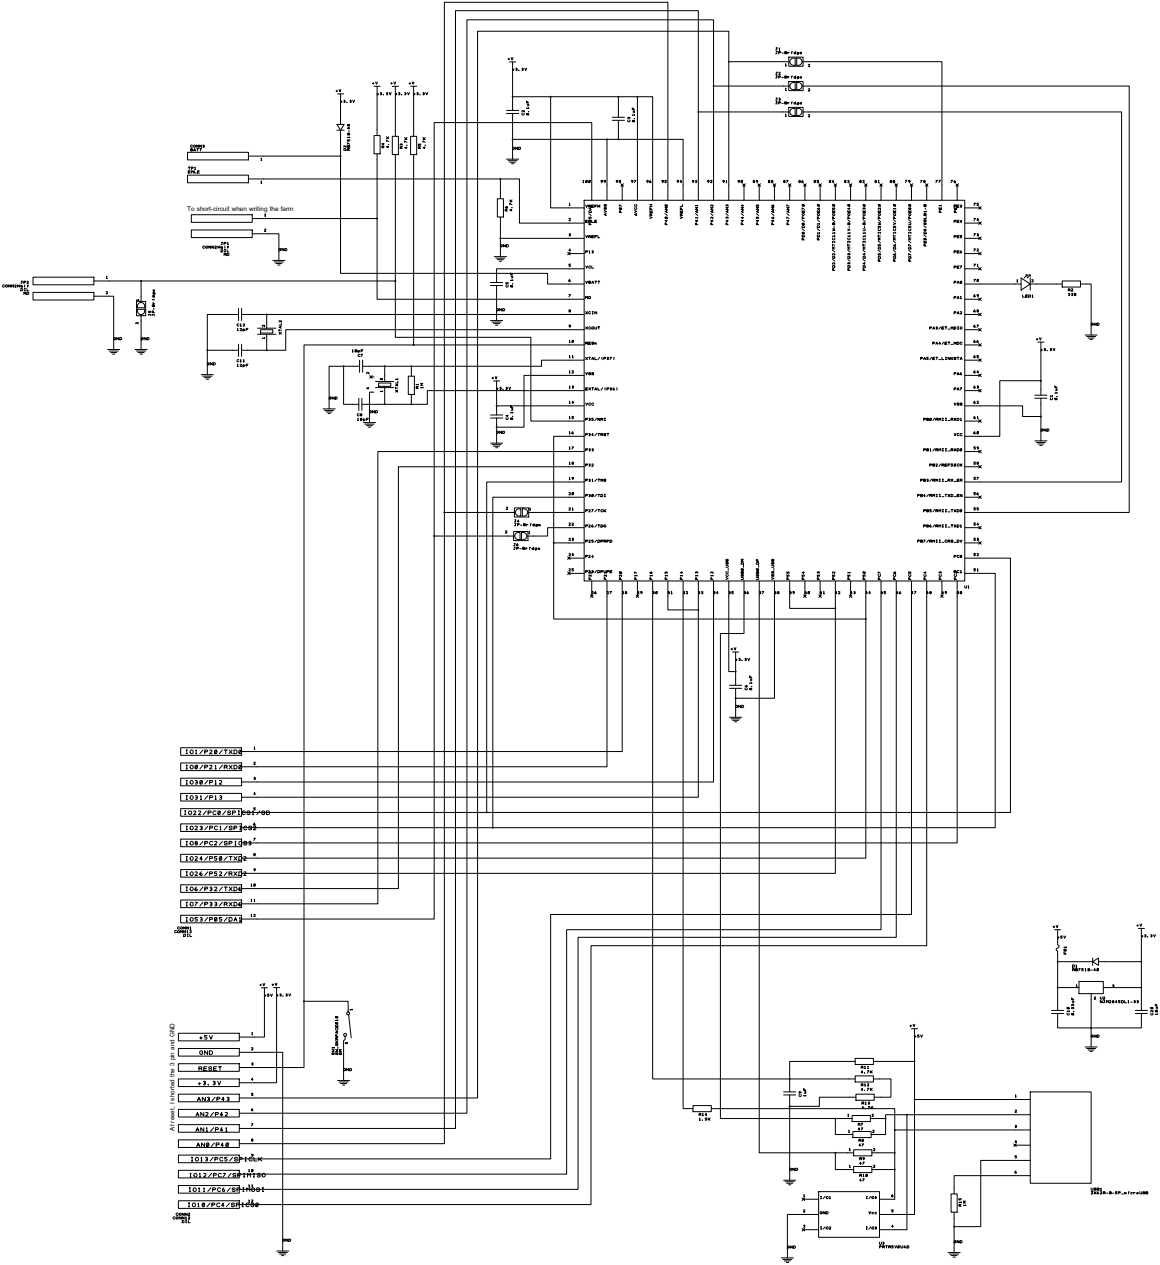
[picture p128: page 1]

To short-circuit when writing the farm

At reset, I shorted the 3 pin and GND
