tarosay/Wakayama-mruby-board/拡張ボード類/WRB-SDWF - Schematic.pdf

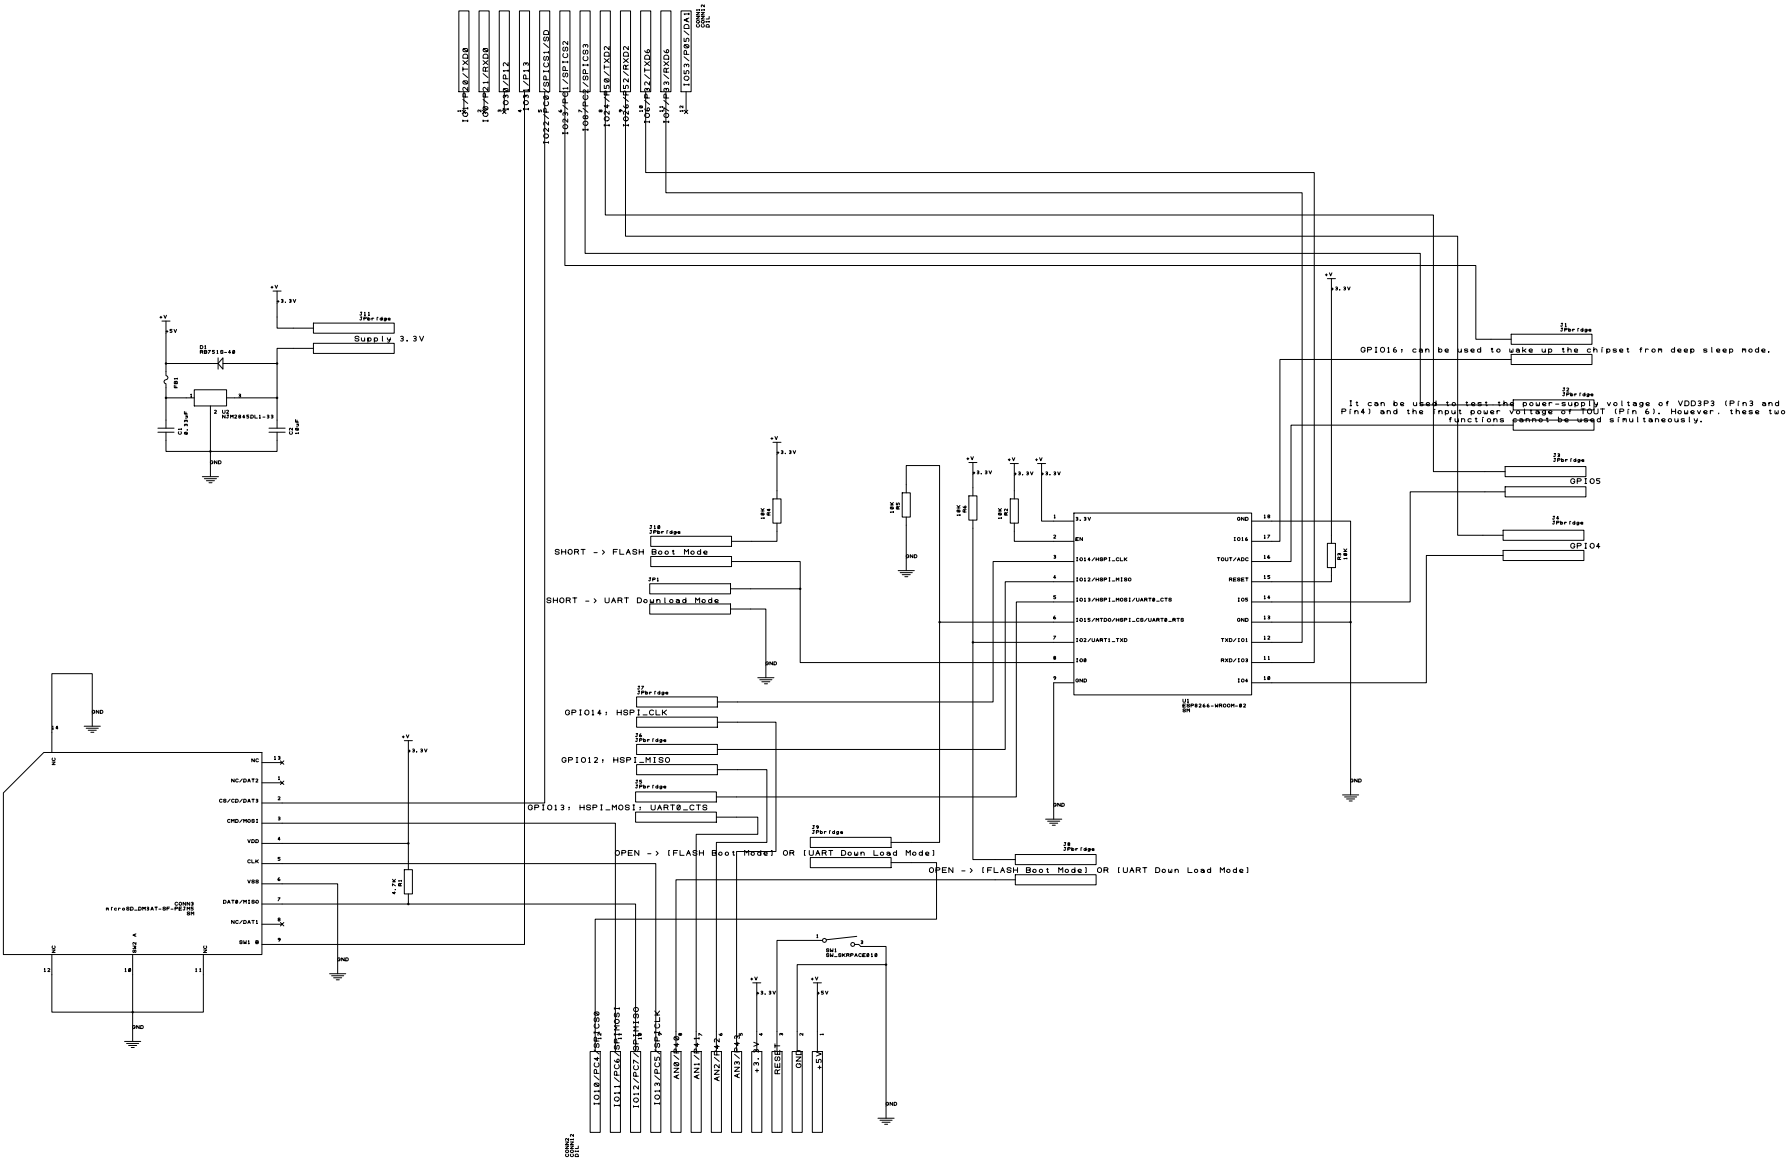
[picture p129: page 1]
