tarosay/Wakayama-mruby-board/wrbb_firmware/wrbb_eepfile/eeploader.cpp

/*
 * EEPROM FIle Loader
 *
 * Copyright (c) 2015 Minao Yamamoto
 *
 * This software is released under the MIT License.
 * 
 * http://opensource.org/licenses/mit-license.php
 */
#include <rxduino.h>
#include <eepfile.h>

#include <mruby.h>
#include <mruby/string.h>
#include <mruby/variable.h>
#include <mruby/version.h>

#include <eeploader.h>
#include "../llbruby.h"

#define COMMAND_LENGTH	32

extern char RubyFilename[];

extern uint8_t RubyCode[];
//char *Arry = (char*)RubyCode;
char *WriteData = (char*)RubyCode;
char CommandData[COMMAND_LENGTH];
bool StopFlg = false;		//強制終了フラグ

CSerial *USB_Serial = &Serial;

int Ack_FE_mode = 0;		//0xFEを読んだときのモード。0:0xFEを読んだときに0xFEを返さない。普通にバッファに残す 1:0xFEを返す, 2:割り込みを発生させない

//#define    DEBUG                1        // Define if you want to debug

#ifdef DEBUG
#  define DEBUG_PRINT(m,v)    { Serial.print("** "); Serial.print((m)); Serial.print(":"); Serial.println((v)); }
#else
#  define DEBUG_PRINT(m,v)    // do nothing
#endif

////**************************************************
//// 0xFEを受信したら無条件に0xFEをエコーバックします
////**************************************************
//int USB_read()
//{
//	int dat = USB_Serial->read();
	//if(dat == -2){
	//	USB_Serial->write(0xFE);

	//	DEBUG_PRINT("USB_read","0xFE");
	//}

//	return dat;
//}

//**************************************************
// ライン入力
//**************************************************
void lineinput(char *arry)
{
	int k = 0;
	int len = 0; 

	while(k >= 0){
		k = USB_Serial->read();
		//DEBUG_PRINT("1.lineinput", k);
		delay(10);
	}

	//while(USB_Serial->available()){
	//	USB_read();
	//}

	while(true){
		k = 0;
		while(k <= 0){
			k = USB_Serial->read();
			//DEBUG_PRINT("2.lineinput", k);
			delay(10);
		}

		DEBUG_PRINT("lineinput", k);

		if (k == 13 || k == 10){
			break;		
		}
		else if (k == 8){
			len--;
			if (len < 0){ len = 0; }
		}
		else{
			arry[len] = k;
			len++;
			if (len >= COMMAND_LENGTH){	break;	}
		}
		USB_Serial->print((char)k);
	}

	arry[len] = 0;
}

//**************************************************
// 指定したmsecの間シリアル入力を待ちます
// 戻り値: 0:入力無し, 1:入力あり
//**************************************************
int waitRcv(int msec){

	unsigned long tm = millis() + msec;
	int sa = 0;

	USB_Serial->print("Waiting ");
	while(tm > millis()){
		if (USB_Serial->available() > 0){
			return 1;
		}
		if(sa != (tm - millis()) / 1000){
			sa = (tm - millis()) / 1000;
			USB_Serial->print(" ");
			USB_Serial->print(sa, 10);
		}
	}
	USB_Serial->println("..Wait Error!");
	return 0;
}

//**************************************************
// 16進文字を10進数に変換する
//**************************************************
int HexText2Int(char t0, char t1)
{
	int ans = 0;
	if(t0 >= '0' && t0 <= '9'){
		ans = (t0 - '0') * 16;
	}
	else if(t0 >= 'A' && t0 <= 'F'){
		ans = (t0 - 'A' + 10) * 16;
	}
	else if(t0 >= 'a' && t0 <= 'f'){
		ans = (t0 - 'a' + 10) * 16;
	}

	if(t1 >= '0' && t1 <= '9'){
		ans += t1 - '0';
	}
	else if(t1 >= 'A' && t1 <= 'F'){
		ans += t1 - 'A' + 10;
	}
	else if(t1 >= 'a' && t1 <= 'f'){
		ans += t1 - 'a' + 10;
	}
	return ans;
}

//**************************************************
// ファイルを保存します
// 60sec待って、データが何も送られてこないときには、
// ファイル保存を終了します
//**************************************************
void writefile(const char *fname, int size, char code)
{
	FILEEEP fpj;
	FILEEEP *fp = &fpj;
	unsigned long tm;
	int k = 0;
	int binsize = size;
	int b2a = 0;

	if(code == 'U' || code == 'V'){
		binsize = size / 2;
		b2a = 1;	//バイナリが2バイトのアスキーコードで来ているフラグ
	}

	if(binsize <= 0){ return; }

	if(binsize>=RUBY_CODE_SIZE && (code == 'X' || code == 'V')){
		return;
	}

	USB_Serial->println();

	//シリアルバッファ消去
	while(USB_Serial->available()){ USB_Serial->read();	}

	if(waitRcv(60000) == 0){
		return;
	}
	USB_Serial->println();

	int cnt = 0;
	int binCnt = 0;
	if(code == 'X' || code == 'V'){
		tm = millis() + 2000;
		while(cnt < size){
			if (USB_Serial->available() > 0){
				k = USB_Serial->read();
				cnt++;

				if(b2a > 0){
					if(b2a > 1){
						binCnt--;
						k = HexText2Int(WriteData[binCnt], k);
						b2a = 1;
					}
					else{
						b2a++;
					}
				}
				WriteData[binCnt] = k;
				binCnt++;
				tm = millis() + 2000;
			}
			if(tm < millis()){	break;	}
		}
	}

	if(tm < millis()){
		USB_Serial->println("..Read Error!");
		return;
	}

	USB_Serial->print(fname);
	USB_Serial->print(" Saving");

	if(EEP.fopen(fp, fname, EEP_WRITE) == -1){
		return;
	}

	if(code == 'X' || code == 'V'){
		for(int i=0; i<binsize; i++){
			if(EEP.fwrite(fp, WriteData[i]) == -1){
				break;
			}
			if((i%256) == 0){
				USB_Serial->print(".");
			}
		}
	}
	else{
		tm = millis() + 2000;
		cnt = 0;
		while(cnt < size){
			if (USB_Serial->available() > 0){
				k = USB_Serial->read();
				cnt++;

				if(b2a > 0){
					if(b2a > 1){
						k = HexText2Int(WriteData[0], k);
						b2a = 1;

						if(EEP.fwrite(fp, (char)k) == -1){
							break;
						}
					}
					else{
						WriteData[0] = k;
						b2a++;
					}
				}
				else{
					if(EEP.fwrite(fp, (char)k) == -1){
						break;
					}
				}
				
				if((cnt%256) == 0){
					USB_Serial->print(".");
				}
				tm = millis() + 2000;
			}
			if(tm < millis()){	break;	}
		}
	}
	
	EEP.fclose(fp);

	USB_Serial->println(".");
	
	StopFlg = true;
}

//**************************************************
// ファイルを読み出します
// 60sec待って、データが何も送られてこないときには、
// ファイル読み出しを終了します
//**************************************************
void readfile(const char *fname, char code)
{
	FILEEEP fpj;
	FILEEEP *fp = &fpj;
	unsigned long tm;
	int k = 0;
	int binsize;

	USB_Serial->println();

	//シリアルバッファ消去
	while(k >= 0){	k = USB_Serial->read();	}

	//60sec間入力を待ちます
	if(waitRcv(60000) == 0){
		return;
	}

	//シリアルバッファ消去
	k = USB_Serial->read();
	while(k >= 0){	k = USB_Serial->read();	}

	USB_Serial->println();

	//ファイルサイズの取得
	binsize = EEP.ffilesize(fname);

	//ファイルサイズの送信
	USB_Serial->println(binsize, 10);

	//60sec間入力を待ちます
	if(waitRcv(60000) == 0){
		return;
	}

	//シリアルバッファ消去
	k = USB_Serial->read();
	while(k >= 0){	k = USB_Serial->read();	}

	//ファイルオープン
	if(EEP.fopen(fp, fname, EEP_READ) == -1){
		USB_Serial->println("..Read Error!");
		return;
	}

	for(int i=0; i<binsize; i++){

		if(code == 'G'){
			USB_Serial->write((unsigned char)EEP.fread(fp));
		}
		else{
			USB_Serial->print(EEP.fread(fp));
		}
	}
	EEP.fclose(fp);
}

//**************************************************
// ファイルローダー
// 戻り値 0:何もしない, 1:強制終了する
//**************************************************
int fileloader(const char* str0, const char* str1)
{
	char fname[COMMAND_LENGTH];
	int size = 0;

#if BOARD == BOARD_GR
	int led = digitalRead(PIN_LED0) | ( digitalRead(PIN_LED1)<<1) | (digitalRead(PIN_LED2)<<2)| (digitalRead(PIN_LED3)<<3);
#else
	int led = digitalRead(RB_LED);
#endif


	char tc[2];
	char *fs[4];

	StopFlg = false;

	tc[0] = CommandData[0];
	tc[1] = CommandData[1];

	//USB_Serial->println(">");
	while(true){

		//LEDを点灯する
#if BOARD == BOARD_GR
		digitalWrite(PIN_LED0, HIGH);
		digitalWrite(PIN_LED1, HIGH);
		digitalWrite(PIN_LED2, HIGH);
		digitalWrite(PIN_LED3, HIGH);
#else
		digitalWrite(RB_LED, HIGH);
#endif
		//コマンド待ち
		USB_Serial->println();
		USB_Serial->print("WAKAYAMA.RB Board Ver.");
		USB_Serial->print(str0);
		if(str1[0] != 0){
			USB_Serial->print(", mruby ");
			USB_Serial->print(str1);
		}
		USB_Serial->println(" (help->H [ENTER])");
		USB_Serial->print(">");

		lineinput((char*)CommandData);

		USB_Serial->println();

		//DEBUG_PRINT("CommandData[0]", (char)CommandData[0]);

		if(CommandData[0] == '.'){
			CommandData[0] = tc[0];
			CommandData[1] = tc[1];

			USB_Serial->print(">");
			USB_Serial->println((char*)CommandData);
		}
		tc[0] = CommandData[0];
		tc[1] = CommandData[1];

		//DEBUG_PRINT("CommandData", (char*)CommandData);

		if (CommandData[0] == 'Z'){
			EEP.format();
		}
		else if (CommandData[0] == 'D'){
			if(strlen(CommandData) > 2){

				//ファイル名を取得
				int len = strlen(CommandData);
				for(int i=0; i<len; i++){
					if(CommandData[i] == ' '){
						fs[0] = &CommandData[i+1];
						break;
					}
				}
				strcpy(fname, fs[0]);
				EEP.fdelete((const char*)fname);
			}
		}
		else if (CommandData[0] == 'G' || CommandData[0] == 'F'){
			if(strlen(CommandData) > 2){

				//ファイル名を取得
				int len = strlen(CommandData);
				for(int i=0; i<len; i++){
					if(CommandData[i] == ' '){
						fs[0] = &CommandData[i+1];
						break;
					}
				}
				strcpy(fname, fs[0]);

				readfile(fname, CommandData[0]);
			}
		}
		else if (CommandData[0] == 'R'){
			if(strlen(CommandData) > 2){

				//ファイル名を取得
				int len = strlen(CommandData);
				for(int i=0; i<len; i++){
					if(CommandData[i] == ' '){
						fs[0] = &CommandData[i+1];
						break;
					}
				}
				strcpy(fname, fs[0]);
				strcpy( (char*)RubyFilename, fname );

				len = strlen(RubyFilename);
				if(RubyFilename[len-4] != '.'
					|| RubyFilename[len-3] != 'm'
					|| RubyFilename[len-2] != 'r'
					|| RubyFilename[len-1] != 'b'){
	
					strcat(RubyFilename, ".mrb");				
				}

				//強制終了フラグを立てる
				StopFlg = true;
				break;
			}
		}
		else if(CommandData[0] == 'W' || CommandData[0] == 'U'){
			if(strlen(CommandData) > 3){
				//スペースを0に変えて、ポインタを取得
				int j = 0;
				int len = strlen(CommandData);
				for(int i=0; i<len; i++){
					if(CommandData[i] == ' '){
						CommandData[i] = 0;
						fs[j] = &CommandData[i+1];
						j++;
						if(j>2){	break;	}
					}
				}
				strcpy(fname, fs[0]);
				size = atoi(fs[1]);

				//0xFEアックを返さないようにする
				if(Ack_FE_mode == 1 && CommandData[0] == 'W'){ Ack_FE_mode = 0; }

				//ファイルを保存します
				writefile(fname, size, CommandData[0]);

				//Ack_FE_mode==0だったら、0xFEアックを返すように戻す
				if(Ack_FE_mode == 0 && CommandData[0] == 'W'){ Ack_FE_mode = 1; }

				for(int i=0; i<j; i++){ *(fs[i] - 1) = ' '; }
			}
		}
		else if(CommandData[0] == 'X' || CommandData[0] == 'V'){
			if(strlen(CommandData) > 3){
				//スペースを0に変えて、ポインタを取得
				int j = 0;
				int len = strlen(CommandData);
				for(int i=0; i<len; i++){
					if(CommandData[i] == ' '){
						CommandData[i] = 0;
						fs[j] = &CommandData[i+1];
						j++;
						if(j>2){	break;	}
					}
				}
				strcpy(fname, fs[0]);
				size = atoi(fs[1]);

				strcpy( (char*)RubyFilename, fname );

				len = strlen(RubyFilename);
				if(RubyFilename[len-4] != '.'
					|| RubyFilename[len-3] != 'm'
					|| RubyFilename[len-2] != 'r'
					|| RubyFilename[len-1] != 'b'){
	
					strcat(RubyFilename, ".mrb");				
				}

				//0xFEアックを返さないようにする
				if(Ack_FE_mode == 1 && CommandData[0] == 'X'){ Ack_FE_mode = 0; }

				//ファイルを保存します
				writefile(RubyFilename, size, CommandData[0]);

				//Ack_FE_mode==0だったら、0xFEアックを返すように戻す
				if(Ack_FE_mode == 0 && CommandData[0] == 'X'){ Ack_FE_mode = 1; }

				for(int i=0; i<j; i++){ *(fs[i] - 1) = ' '; }

				//強制終了フラグを立てる
				StopFlg = true;
				break;
			}
		}
		else if(CommandData[0] == 'E'){
			//ファームウェア書き込み待ちにする
			system_reboot( REBOOT_USERAPP );	//リセット後にユーザアプリを起動する
			//system_reboot( REBOOT_FIRMWARE );	//リセット後にファームウェアを起動する
		}
		else if (CommandData[0] == 'L'){
			USB_Serial->println();
			for(int i=0; i<64; i++){
					
				size = EEP.fdir( i, fname );
					
				if(fname[0] != 0){
					USB_Serial->print(" ");
					USB_Serial->print(fname);
					USB_Serial->print(" ");
					USB_Serial->print(size);
					USB_Serial->println(" byte");
				}
			}
		}
		else if(CommandData[0] == 'A'){
			EEP.viewFat();
		}
		else if(CommandData[0] == 'S'){
			if(strlen(CommandData) > 2){

				int len = strlen(CommandData);
				for(int i=0; i<len; i++){
					if(CommandData[i] == ' '){
						fs[0] = &CommandData[i+1];
						break;
					}
				}
				EEP.viewSector( atoi(fs[0]) );
			}
		}
		else if(CommandData[0] == 'Q'){
			break;
		}
		else{
			USB_Serial->println();
			if(Ack_FE_mode == 1){
				USB_Serial->print("*");
			}
			USB_Serial->println("EEPROM FileWriter Ver. 1.58");
			USB_Serial->println(" Command List");
			USB_Serial->println(" L:List Filename..........>L [ENTER]");
			USB_Serial->println(" W:Write File.............>W Filename Size [ENTER]");
			USB_Serial->println(" G:Get File...............>G Filename [ENTER]");
			//USB_Serial->println(" F:Get File B2A...........>F Filename [ENTER]");
			USB_Serial->println(" D:Delete File............>D Filename [ENTER]");
			//USB_Serial->println(" Z:Delete All Files.......>Z [ENTER]");
			//USB_Serial->println(" A:List FAT...............>A [ENTER]");
			USB_Serial->println(" R:Run File...............>R Filename [ENTER]");
			USB_Serial->println(" X:Execute File...........>X Filename Size [ENTER]");
			//USB_Serial->println(" S:List Sector............>S Number [ENTER]");
			USB_Serial->println(" .:Repeat.................>. [ENTER]");
			USB_Serial->println(" Q:Quit...................>Q [ENTER]");
			USB_Serial->println(" E:System Reset...........>E [ENTER]");
			//USB_Serial->println(" U:Write File B2A.........>U Filename Size [ENTER]");
			//USB_Serial->println(" V:Execute File B2A.......>V Filename Size [ENTER]");
		}
	}

#if BOARD == BOARD_GR
	digitalWrite(PIN_LED0, led & 1);
	digitalWrite(PIN_LED1, (led >> 1) & 1);
	digitalWrite(PIN_LED2, (led >> 2) & 1);
	digitalWrite(PIN_LED3, (led >> 3) & 1);
#else
	digitalWrite(RB_LED, led);
#endif

	if(StopFlg == true){
		return 1;
	}

	return 0;
}
