tarosay/Wakayama-mruby-board/wrbb_firmware/wrbb_mruby/sSys.cpp

/*
 * システム関連
 *
 * Copyright (c) 2015 Minao Yamamoto
 *
 * This software is released under the MIT License.
 * 
 * http://opensource.org/licenses/mit-license.php
 */
#include <rxduino.h>
#include <eeprom.h>

#include <mruby.h>
#include <mruby/string.h>
#include <mruby/variable.h>
#include <mruby/version.h>
#include <eeploader.h>

#include "sExec.h"
#include "../llbruby.h"

#define EEPROMADDRESS	0xFF

extern volatile char ProgVer[];
extern char RubyFilename[];

//**************************************************
// 終了させます
//	System.exit()
//	エラー値がもどり、即終了
//**************************************************
mrb_value mrb_system_exit(mrb_state *mrb, mrb_value self)
{

	mrb_raise(mrb, mrb_class_get(mrb, "Sys#exit Called"), "Normal Completion");

	return mrb_nil_value();	//戻り値は無しですよ。
}

//**************************************************
// 次に実行するスクリプトファイルをVmFilenameにセットします。
// System.setRun( filename )
//**************************************************
mrb_value mrb_system_setrun(mrb_state *mrb, mrb_value self)
{
mrb_value text;

	mrb_get_args(mrb, "S", &text);
	char *str = RSTRING_PTR(text);

	strcpy( (char*)RubyFilename, (char*)str );

	return mrb_nil_value();	//戻り値は無しですよ。
}

//**************************************************
// システムのバージョンを取得します
// System.version([R])
// 引数があればmrubyのバーションを返す
//**************************************************
mrb_value mrb_system_version(mrb_state *mrb, mrb_value self)
{
int tmp;

	int n = mrb_get_args(mrb, "|i", &tmp);

	if( n>=1 ){
		//return mrb_const_get(mrb, mrb_obj_value(mrb->kernel_module), mrb_intern_lit(mrb, "MRUBY_VERSION"));
		return mrb_str_new_cstr(mrb, MRUBY_VERSION);
	}
	return mrb_str_new_cstr(mrb, (const char*)ProgVer);
}

//**************************************************
//フラッシュメモリに書き込みます
// System.push(address, buf, length)
//	address: 書き込み開始アドレス(0x0000～0x00ff)
//  buf: 書き込むデータ
//  length: 書き込むサイズ
// 戻り値
//  1:成功, 0:失敗
//**************************************************
mrb_value mrb_system_push(mrb_state *mrb, mrb_value self)
{
int		address;
mrb_value value;
int		len;
char	*str;

	mrb_get_args(mrb, "iSi", &address, &value, &len);

	str = RSTRING_PTR(value);

	if(address > EEPROMADDRESS){
		return mrb_fixnum_value( 0 );
	}

	int ret = 1;
	for(int i=0; i<len; i++){
		ret = EEPROM.write( (unsigned long)address, (unsigned char)str[i] );
		if(ret==-1){
			ret = 0;
			break;
		}
		address++;
	}

	return mrb_fixnum_value( ret );
}

//**************************************************
//フラッシュメモリから読み出します
// System.pop(address, length)
//	address: 読み込みアドレス(0x0000～0x00ff)
//  length: 読み込みサイズ(MAX 32バイト)
// 戻り値
//  読み込んだデータ
//**************************************************
mrb_value mrb_system_pop(mrb_state *mrb, mrb_value self)
{
unsigned char str[32];
int		address;
int		len;

	mrb_get_args(mrb, "ii", &address, &len);

	if(len>32){
		len = 32;
	}

	if(address > EEPROMADDRESS){
		return mrb_str_new(mrb, (const char *)str, 0);
	}

	for(int i=0; i<len; i++){
		str[i] = EEPROM.read( (unsigned long)address );
		address++;
	}
	
	return mrb_str_new(mrb, (const char *)str, len);
}

//**************************************************
// ファイルローダーを呼び出します
// System.fileload()
//**************************************************
mrb_value mrb_system_fileload(mrb_state *mrb, mrb_value self)
{
	//ファイルローダーの呼び出し
	if(fileloader((const char*)ProgVer,MRUBY_VERSION) == 1){
		mrb_full_gc(mrb);	//強制GCを入れる
		//強制終了
		mrb_raise(mrb, mrb_class_get(mrb, "Sys#exit Called"), "Normal Completion");
	}
	
	mrb_full_gc(mrb);	//強制GCを入れる

	return mrb_nil_value();	//戻り値は無しですよ。
}

//**************************************************
// リセットします
// System.reset()
//**************************************************
mrb_value mrb_system_reset(mrb_state *mrb, mrb_value self)
{
	system_reboot( REBOOT_USERAPP );	//リセット後にユーザアプリを起動する

	return mrb_nil_value();	//戻り値は無しですよ。
}

//**************************************************
// ライブラリを定義します
//**************************************************
void sys_Init(mrb_state *mrb)
{
	struct RClass *systemModule = mrb_define_module(mrb, "System");

	mrb_define_module_function(mrb, systemModule, "exit", mrb_system_exit, MRB_ARGS_NONE());
	mrb_define_module_function(mrb, systemModule, "reset", mrb_system_reset, MRB_ARGS_NONE());
	mrb_define_module_function(mrb, systemModule, "setrun", mrb_system_setrun, MRB_ARGS_REQ(1));
	mrb_define_module_function(mrb, systemModule, "version", mrb_system_version, MRB_ARGS_OPT(1));

	mrb_define_module_function(mrb, systemModule, "push", mrb_system_push, MRB_ARGS_REQ(3));
	mrb_define_module_function(mrb, systemModule, "pop", mrb_system_pop, MRB_ARGS_REQ(2));

	mrb_define_module_function(mrb, systemModule, "fileload", mrb_system_fileload, MRB_ARGS_NONE());
}
