tarosay/Wakayama-mruby-board/(commit log)

2015-08-24 Add a description of the expansion shield
    [WRB-SDWF (rsbom).xlsx]
2016-03-02 図面の追加
    [Wakayamarb5_2.sch]
